denisgav/solderless_breadboard_psu/Doc/usbuart-schematic-2.png

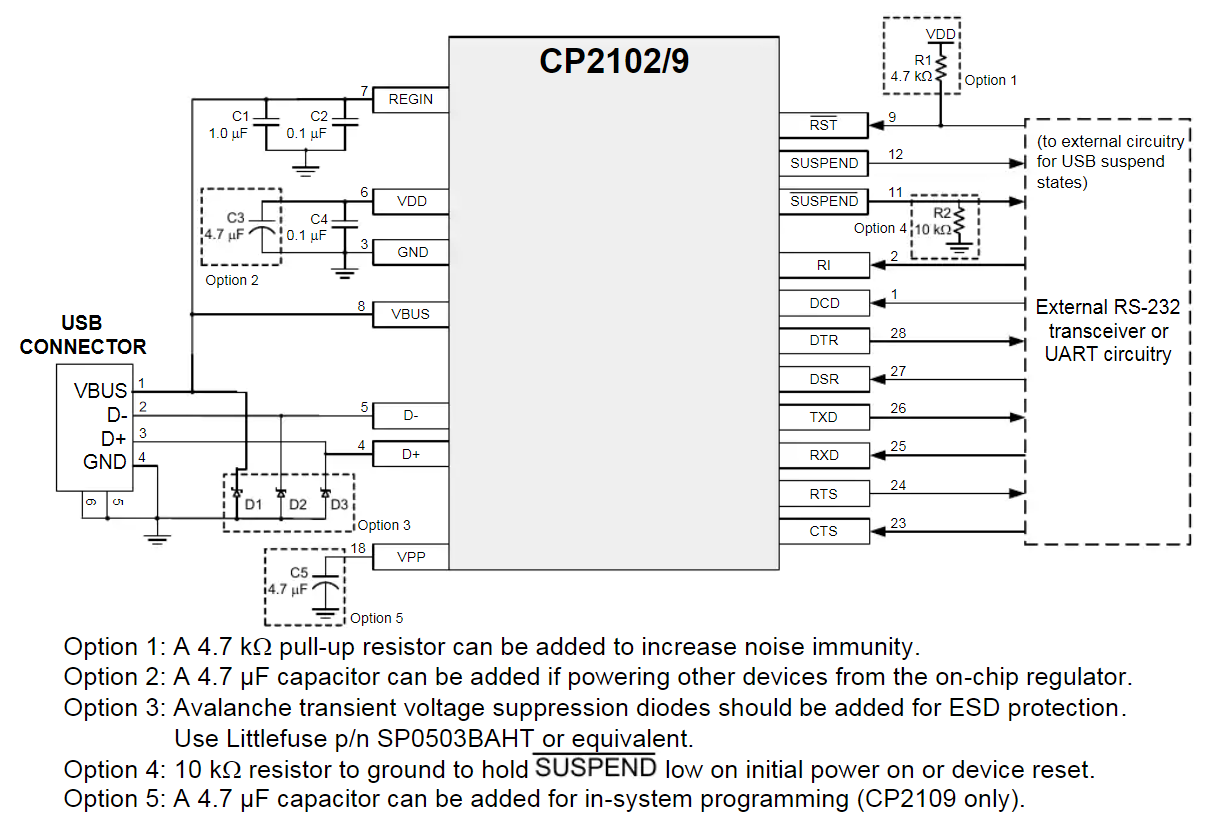
Doc/usbuart-schematic-2.png
