denisgav/solderless_breadboard_psu/Doc/usbuart-schematic.png

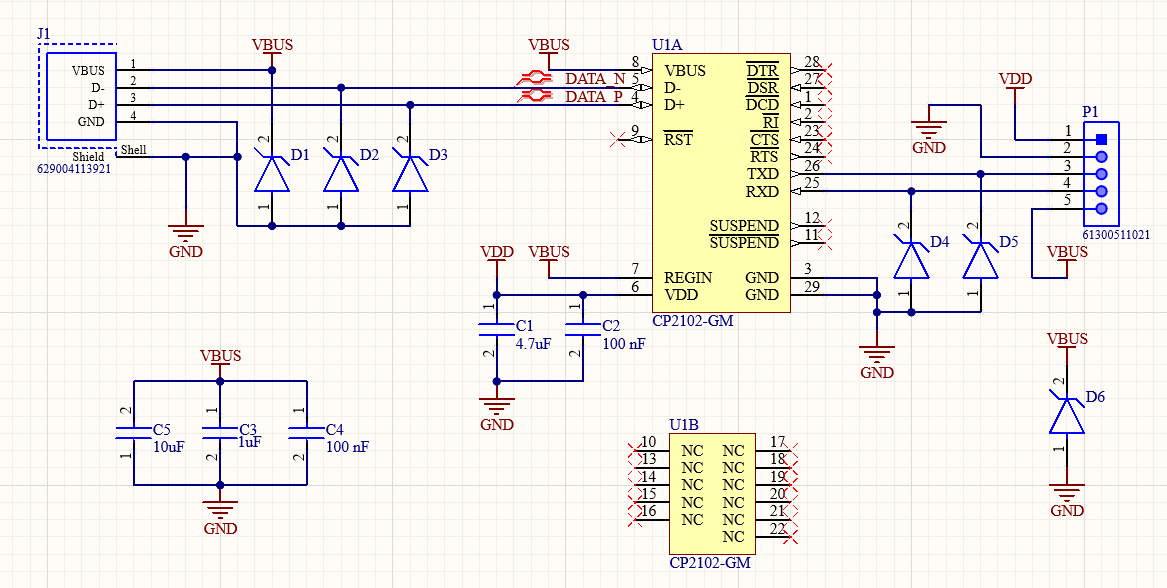
Doc/usbuart-schematic.png
