denisgav/solderless_breadboard_psu/not_ordered.ods

Reference | Qty | Value | DNP | Exclude from BOM | Exclude from Board | Footprint | Datasheet | Manufacturer | Manufacturer Part Number
D401 | 1 | SS14 |  |  |  | Diode_SMD:D_0603_1608Metric | https://www.vishay.com/docs/88746/ss12.pdf | Schottky Diode | SD0603S040S0R2
L401 | 1 | 10uH |  |  |  | Inductor_SMD:L_Changjiang_FXL0630 | ~ | cjiang (Changjiang Microelectronics Tech) | FXL0630-100-M
L402 | 1 | 15uH |  |  |  | Inductor_SMD:L_Changjiang_FXL0630 | ~ | cjiang (Changjiang Microelectronics Tech) | FXL0630-150-M
R301,R401 | 2 | 100kR |  |  |  | Resistor_SMD:R_0402_1005Metric | ~ | UNI-ROYAL(Uniroyal Elec) | 0402WGF1003TCE
R302,R405,R406,R503,R504,R601,R602,R603,R604,R605,R606 | 11 | 510R |  |  |  | Resistor_SMD:R_0402_1005Metric | ~ | UNI-ROYAL(Uniroyal Elec) | 0402WGF5100TCE
R303,R501,R502 | 3 | 5k1R |  |  |  | Resistor_SMD:R_0402_1005Metric | ~ | UNI-ROYAL(Uniroyal Elec) | 0402WGF5101TCE
R304 | 1 | 330R |  |  |  | Resistor_SMD:R_0402_1005Metric | ~ | UNI-ROYAL(Uniroyal Elec) | 0402WGF3300TCE
R305 | 1 | 2k2R |  |  |  | Resistor_SMD:R_0402_1005Metric | ~ | UNI-ROYAL(Uniroyal Elec) | 0402WGF2201TCE
R402,R505 | 2 | 1MR |  |  |  | Resistor_SMD:R_0402_1005Metric | ~ | UNI-ROYAL(Uniroyal Elec) | 0402WGF1004TCE
R403 | 1 | 22kR |  |  |  | Resistor_SMD:R_0402_1005Metric | ~ | UNI-ROYAL(Uniroyal Elec) | 0402WGF2202TCE
R404 | 1 | 330kR |  |  |  | Resistor_SMD:R_0402_1005Metric | ~ | UNI-ROYAL(Uniroyal Elec) | 0402WGF3303TCE
U501 | 1 | USBLC6-2SC6 |  |  |  | Package_TO_SOT_SMD:SOT-23-6 | https://www.st.com/resource/en/datasheet/usblc6-2.pdf | STMicroelectronics | USBLC6-2SC6
