denisgav/solderless_breadboard_psu/KiCad/v2/components/CP2102N-A02-GQFN20R/CP2102N-A02-GQFN20R.stp

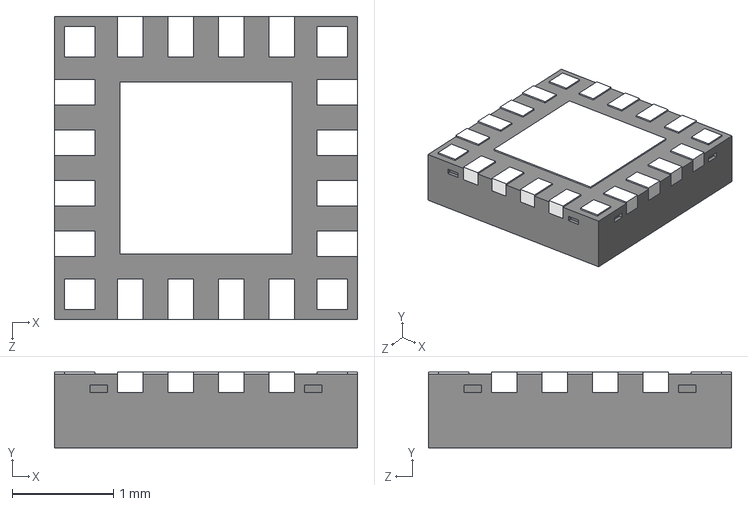
[picture p3: CAD file, 2026-05-03]
KiCad/v2/components/CP2102N-A02-GQFN20R/CP2102N-A02-GQFN20R.stp
3.00 x 0.75 x 3.00 mm
