denisgav/solderless_breadboard_psu/KiCad/v2/components/CP2102N-A02-GQFN24R/CP2102N-A02-GQFN24R.stp

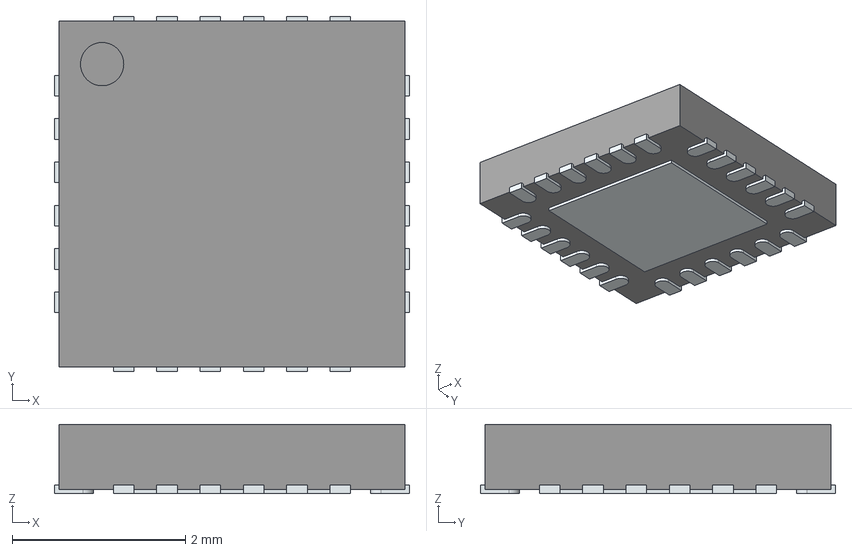
[picture p4: CAD file, 2026-05-03]
KiCad/v2/components/CP2102N-A02-GQFN24R/CP2102N-A02-GQFN24R.stp
4.10 x 4.10 x 0.8 mm
ThermalPin
PinsArrayLR
PinsArrayTB
