denisgav/solderless_breadboard_psu/KiCad/v2/components/HRO  TYPE-C-31-M-12.step

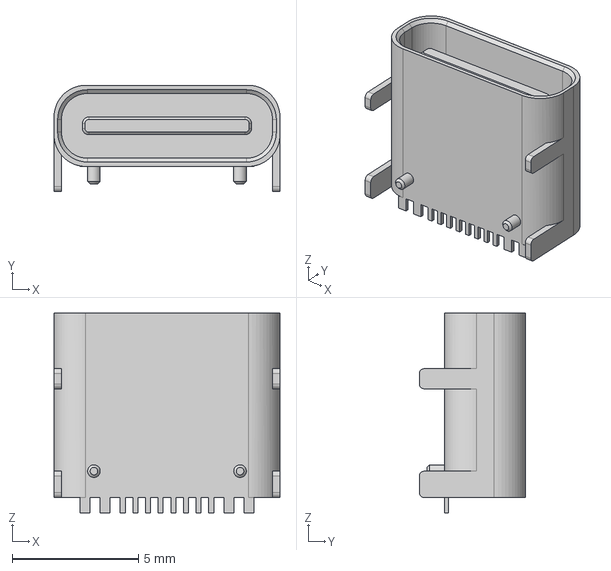
[picture p5: CAD file, 2026-01-18]
KiCad/v2/components/HRO TYPE-C-31-M-12.step
8.94 x 4.21 x 7.90 mm
