denisgav/solderless_breadboard_psu/KiCad/v2/components/SW_PUSH_6mm_H5mm/SW_PUSH_6mm_H5mm.step

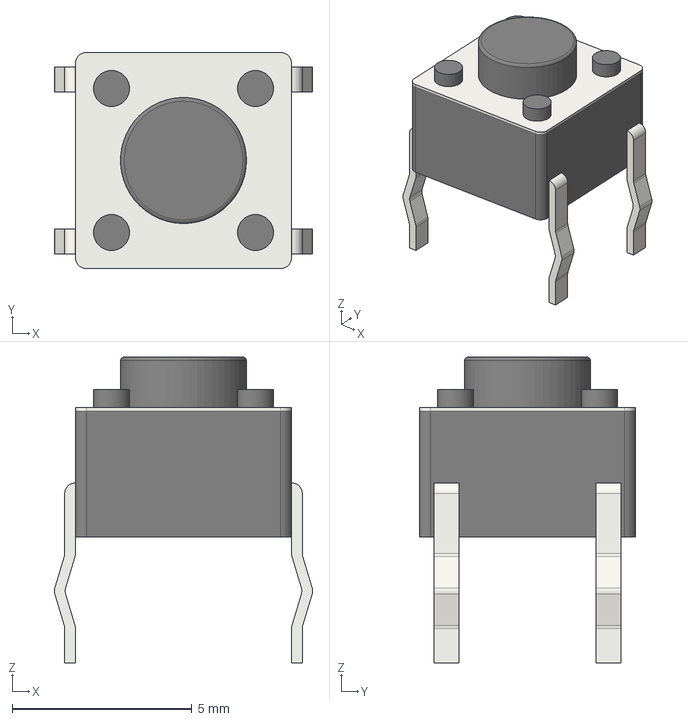
[picture p6: CAD file, 2026-05-06]
KiCad/v2/components/SW_PUSH_6mm_H5mm/SW_PUSH_6mm_H5mm.step
7.17 x 6.00 x 8.50 mm
