denisgav/solderless_breadboard_psu/KiCad/v2/components/TPS63000DRCR/TPS63000DRCR.stp

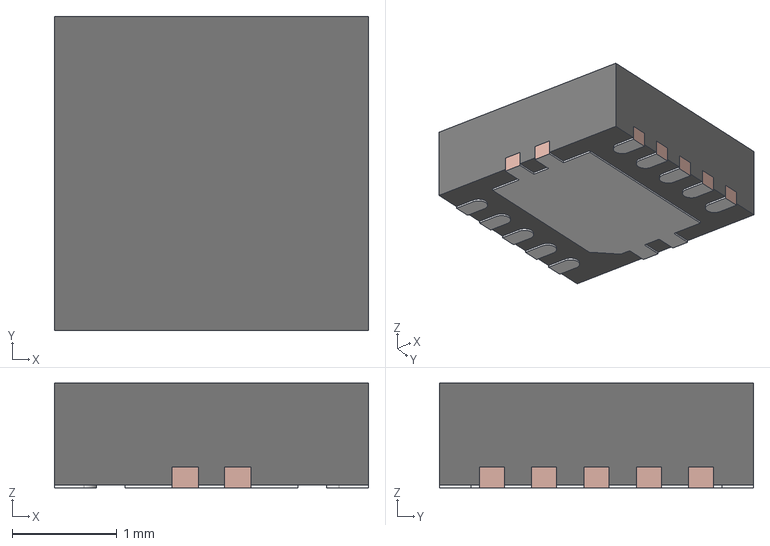
[picture p7: CAD file, 2026-05-03]
KiCad/v2/components/TPS63000DRCR/TPS63000DRCR.stp
3.00 x 3.00 x 1.00 mm
BODY-SON
FRAME-DRC0010J
