denisgav/solderless_breadboard_psu/KiCad/v1/components/BM02B-GHS-TBT_LF__SN__N_/BM02B-GHS-TBT_LF__SN__N_.stp

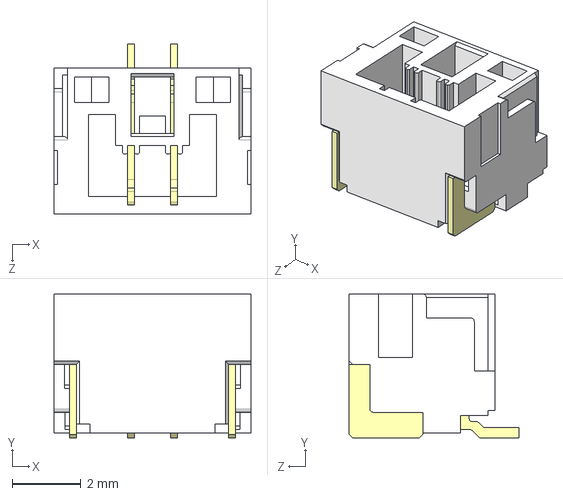
[picture p8: CAD file, 2026-01-10, an earlier design]
KiCad/v1/components/BM02B-GHS-TBT_LF__SN__N_/BM02B-GHS-TBT_LF__SN__N_.stp
5.75 x 4.20 x 4.95 mm
