denisgav/solderless_breadboard_psu/KiCad/v1/components/FT232RL-REEL/FT232RL-REEL.stp

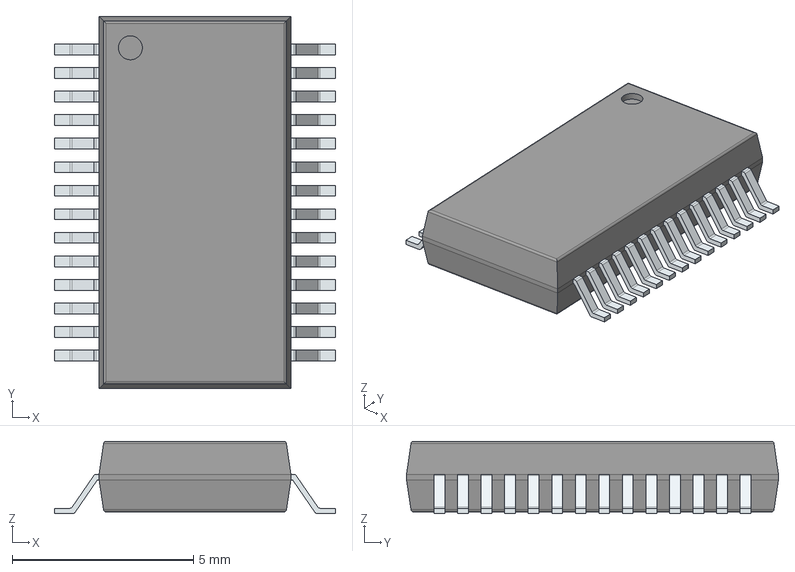
[picture p9: CAD file, 2026-01-10, an earlier design]
KiCad/v1/components/FT232RL-REEL/FT232RL-REEL.stp
7.78 x 10.3 x 2.00 mm
PinsArrayLR
