denisgav/solderless_breadboard_psu/KiCad/v1/components/XKB5858-Z/XKB5858-Z.stp

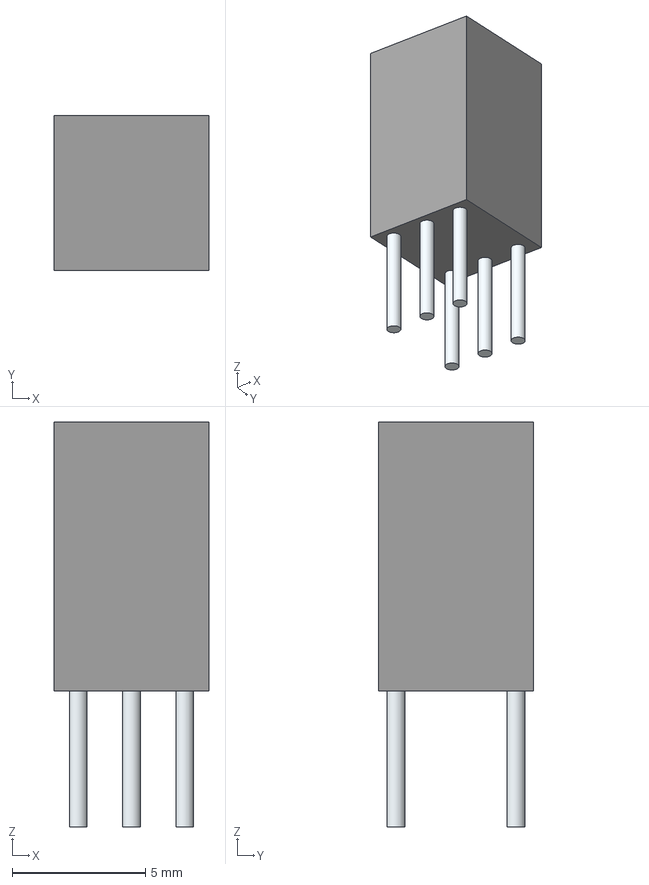
[picture p10: CAD file, 2026-01-10, an earlier design]
KiCad/v1/components/XKB5858-Z/XKB5858-Z.stp
5.80 x 5.80 x 15.2 mm
Leads
