denisgav/solderless_breadboard_psu/KiCad/v1/components/XKB5858-Z/SW_Btn_XLX.step

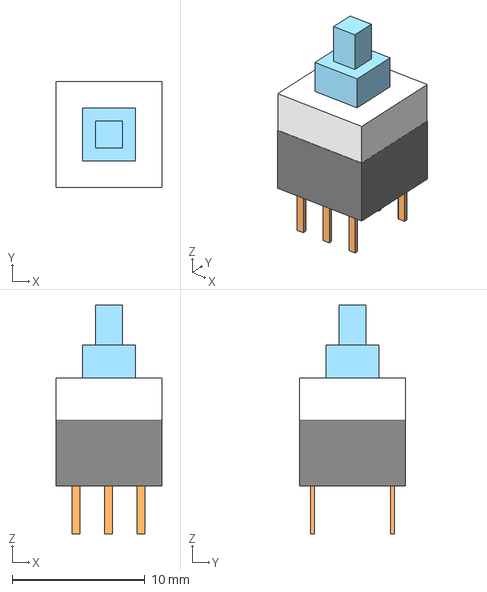
[picture p11: CAD file, 2026-01-10, an earlier design]
KiCad/v1/components/XKB5858-Z/SW_Btn_XLX.step
8.00 x 8.00 x 17.2 mm
