denisgav/solderless_breadboard_psu/KiCad/v1/components/BQ29737DSER/BQ29737DSER.stp

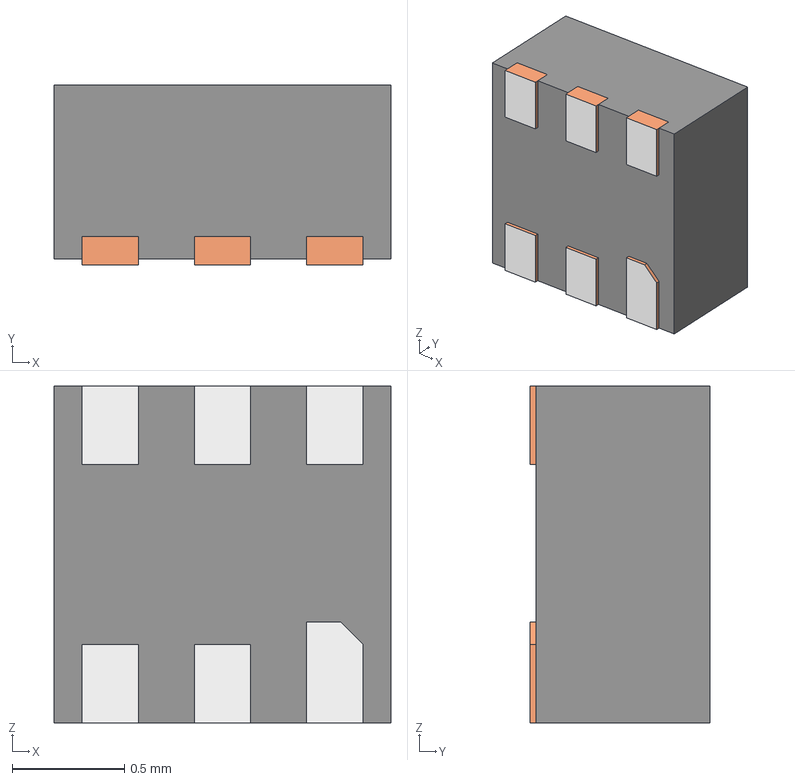
[picture p12: CAD file, 2026-01-10, an earlier design]
KiCad/v1/components/BQ29737DSER/BQ29737DSER.stp
1.50 x 0.8 x 1.50 mm
BODY-SON
FRAME-DSE0006A
