denisgav/solderless_breadboard_psu/KiCad/v1/components/MCP73831T-2ACI_OT/MCP73831T-2ACI_OT.stp

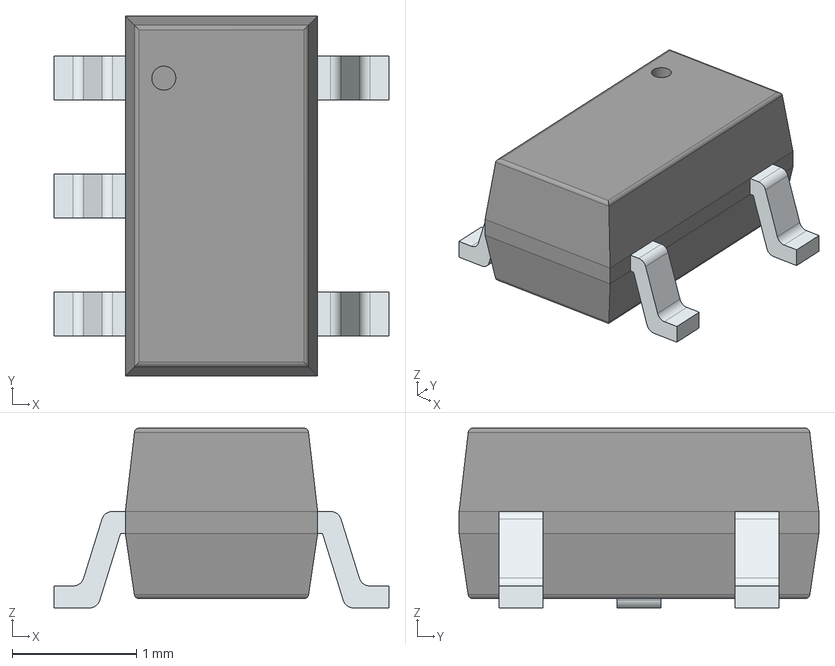
[picture p13: CAD file, 2026-01-10, an earlier design]
KiCad/v1/components/MCP73831T-2ACI_OT/MCP73831T-2ACI_OT.stp
2.70 x 2.90 x 1.45 mm
PinsArrayL
PinsArrayR
