denisgav/solderless_breadboard_psu/KiCad/v1/components/TLV62569DBVR/TLV62569DBVR.stp

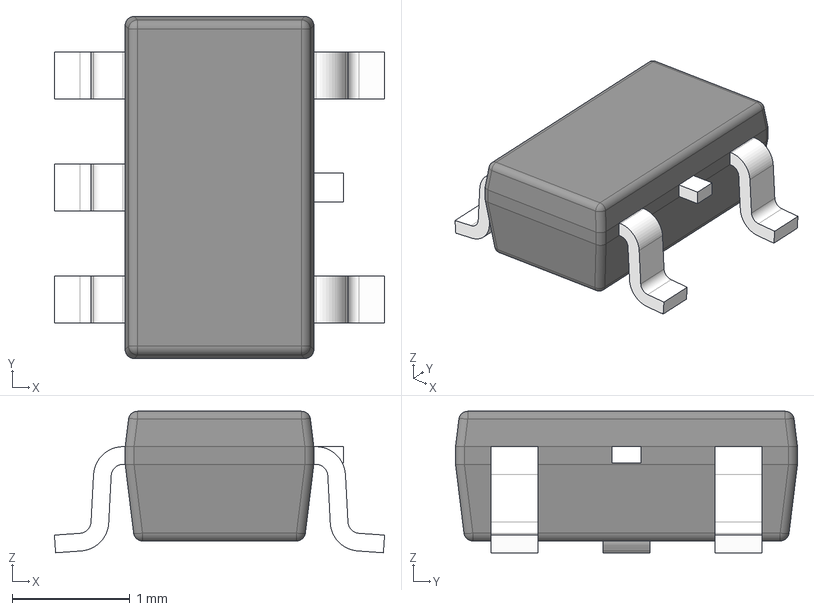
[picture p14: CAD file, 2026-01-10, an earlier design]
KiCad/v1/components/TLV62569DBVR/TLV62569DBVR.stp
2.80 x 2.90 x 1.20 mm
BODY-SOT
LEAD-SOT x 5
LEAD-DUMMY
