denisgav/solderless_breadboard_psu/KiCad/v1/components/TPS61040DBVR/TPS61040DBVR.step

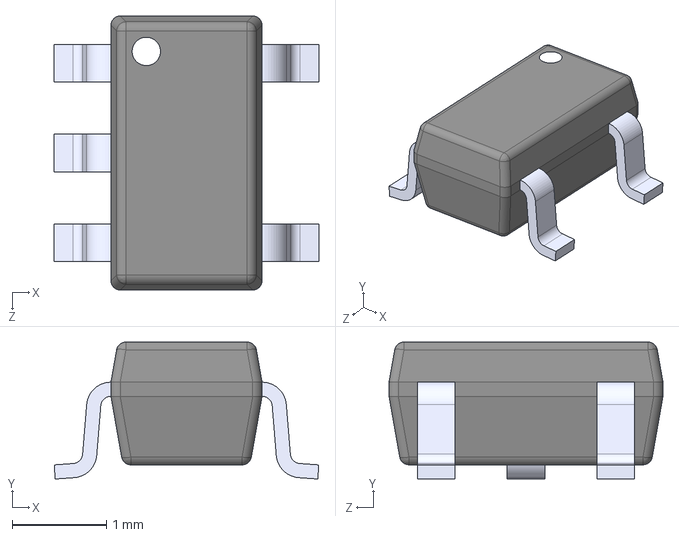
[picture p15: CAD file, 2026-01-10, an earlier design]
KiCad/v1/components/TPS61040DBVR/TPS61040DBVR.step
2.80 x 1.45 x 2.90 mm
