denisgav/solderless_breadboard_psu/KiCad/v2/solderless_breadboard_psu.kicad_pcb

## KiCad design KiCad/v2/solderless_breadboard_psu.kicad_pcb (2026-07-12)

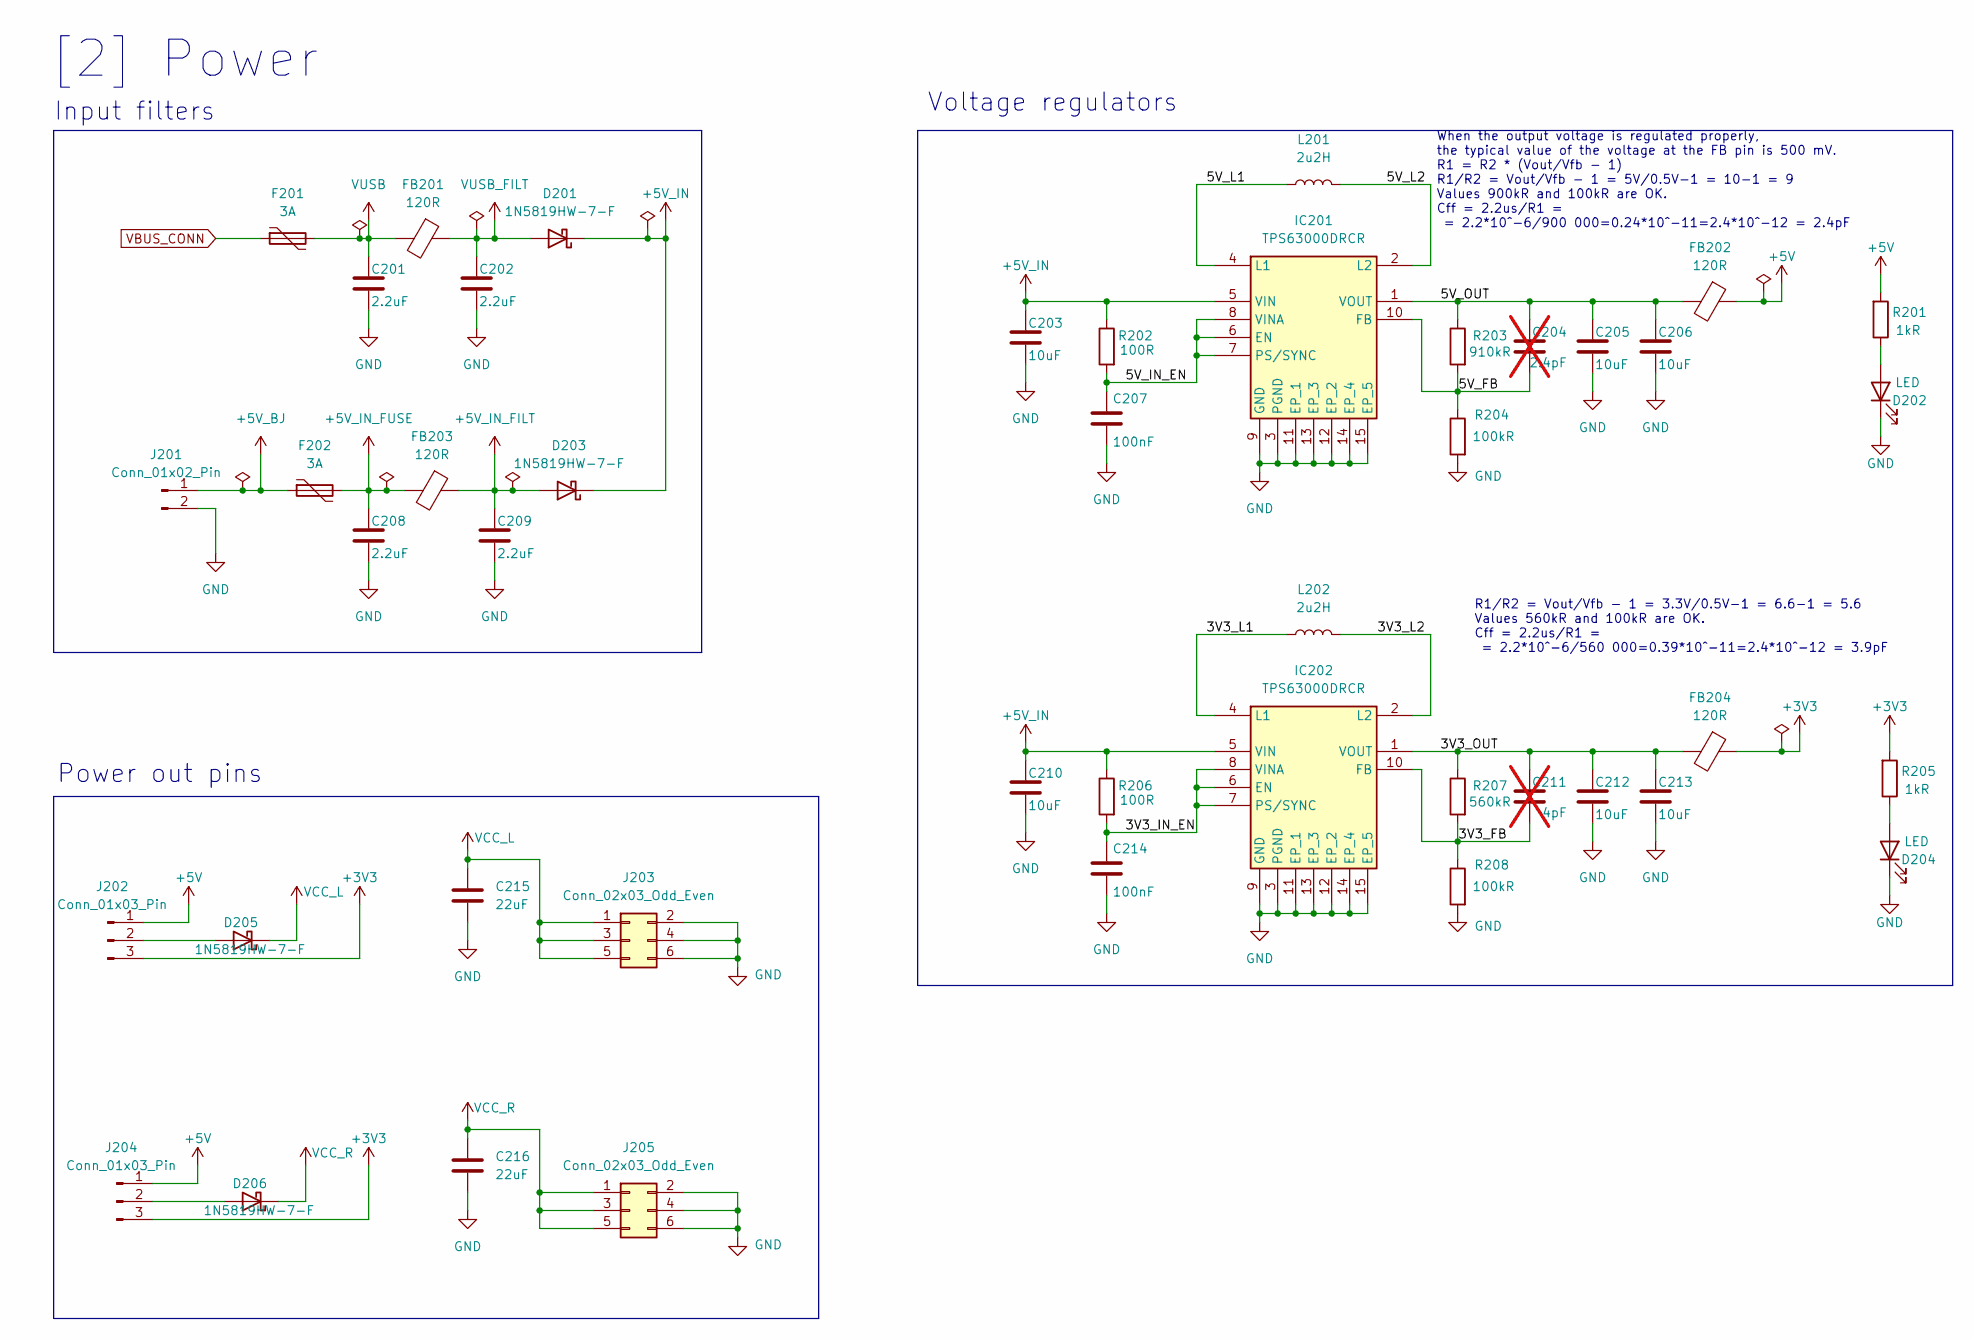
[picture p16: schematic 02_power.kicad_sch]

Parts:
C201, C202, C208, C209: 2.2uF; C_0603_1608Metric; Manufacturer Part Number CL10A225KO8NNNC; LCSC Part Number C23630
C203, C205, C206, C210, C212, C213: 10uF; C_0603_1608Metric; Manufacturer Part Number GRM188R61E106MA73D; LCSC Part Number C91606
C204: 2.4pF; C_0603_1608Metric; Manufacturer Part Number CC0603BRNPO9BN2R4; LCSC Part Number C519102; not fitted
C207, C214: 100nF; C_0402_1005Metric; Manufacturer Part Number GCM155R71H104KE02D; LCSC Part Number C85858
C211: 4pF; C_0603_1608Metric; not fitted
C215, C216: 22uF; C_0603_1608Metric; Manufacturer Part Number CL10A226MP8NUNE; DigiKey Part Number 1276-6687-6-ND
D201, D203, D205, D206: 1N5819HW-7-F; D_SOD-123; Manufacturer Part Number 1N5819HW-7-F; LCSC Part Number C82544
D202, D204: LED; LED_0603_1608Metric; Manufacturer Part Number XL-1608SURC-06; LCSC Part Number C965799
F201, F202: 3A; Fuse_0805_2012Metric; Manufacturer Part Number BSMD0805-100-6V; LCSC Part Number C883112
FB201, FB202, FB203, FB204: 120R; Fuse_0603_1608Metric; Manufacturer Part Number BLM18PG121SN1D; LCSC Part Number C14709
IC201, IC202: TPS63000DRCR; TPS63002DRCR; Manufacturer_Part_Number TPS63000DRCR; Mouser Part Number 595-TPS63000DRCR
J201: Conn_01x02_Pin; PinHeader_1x02_P2.54mm_Vertical
J202, J204: Conn_01x03_Pin; PinHeader_1x03_P2.54mm_Vertical
J203, J205: Conn_02x03_Odd_Even; PinHeader_2x03_P2.54mm_Vertical
L201, L202: 2u2H; L_Changjiang_FXL0630; Manufacturer Part Number FXL0630-2R2-M; LCSC Part Number C167218
R201, R205: 1kR; R_0402_1005Metric; Manufacturer Part Number RC0402FR-071KL; LCSC Part Number C106235
R202, R206: 100R; R_0402_1005Metric; Manufacturer Part Number RT0402BRD07100RL; LCSC Part Number C705627
R203: 910kR; R_0402_1005Metric; Manufacturer Part Number FRC0402F9103TS; LCSC Part Number C2909391
R204, R208: 100kR; R_0402_1005Metric; Manufacturer Part Number RT0402BRD07100KL; LCSC Part Number C852472
R207: 560kR; R_0402_1005Metric; Manufacturer Part Number 0402WGF5603TCE; LCSC Part Number C132339

Connections:
+3V3: FB204.1, J202.3, J204.3, R205.2
+5V: FB202.1, J202.1, J204.1, R201.2
+5V_BJ: F202.1, J201.1
+5V_IN: C203.1, C210.1, D201.1 (K), D203.1 (K), IC201.5 (VIN), IC202.5 (VIN), R202.1, R206.1
+5V_IN_FILT: C209.1, D203.2 (A), FB203.1
+5V_IN_FUSE: C208.1, F202.2, FB203.2
/[2] Power/3V3_FB: C211.2, IC202.10 (FB), R207.2, R208.1
/[2] Power/3V3_IN_EN: C214.1, IC202.6 (EN), IC202.7 (PS/SYNC), IC202.8 (VINA), R206.2
/[2] Power/3V3_L1: IC202.4 (L1), L202.1
/[2] Power/3V3_L2: IC202.2 (L2), L202.2
/[2] Power/3V3_OUT: C211.1, C212.1, C213.1, FB204.2, IC202.1 (VOUT), R207.1
/[2] Power/5V_FB: C204.2, IC201.10 (FB), R203.2, R204.1
/[2] Power/5V_IN_EN: C207.1, IC201.6 (EN), IC201.7 (PS/SYNC), IC201.8 (VINA), R202.2
/[2] Power/5V_L1: IC201.4 (L1), L201.1
/[2] Power/5V_L2: IC201.2 (L2), L201.2
/[2] Power/5V_OUT: C204.1, C205.1, C206.1, FB202.2, IC201.1 (VOUT), R203.1
GND: C201.2, C202.2, C203.2, C205.2, C206.2, C207.2, C208.2, C209.2, C210.2, C212.2, C213.2, C214.2, C215.2, C216.2, D202.1 (K), D204.1 (K), IC201.3 (PGND), IC201.9 (GND), IC201.11 (EP_1), IC201.12 (EP_2), IC201.13 (EP_3), IC201.14 (EP_4), IC201.15 (EP_5), IC202.3 (PGND), IC202.9 (GND), IC202.11 (EP_1), IC202.12 (EP_2), IC202.13 (EP_3), IC202.14 (EP_4), IC202.15 (EP_5), J201.2, J203.2, J203.4, J203.6, J205.2, J205.4, J205.6, R204.2, R208.2; also elsewhere on the board
unnamed: D202.2 (A), R201.1
unnamed: D204.2 (A), R205.1
unnamed: D205.2 (A), J202.2
unnamed: D206.2 (A), J204.2
VBUS_CONN: F201.1; also elsewhere on the board
VCC_L: C215.1, D205.1 (K), J203.1, J203.3, J203.5
VCC_R: C216.1, D206.1 (K), J205.1, J205.3, J205.5
VUSB: C201.1, F201.2, FB201.2; also elsewhere on the board
VUSB_FILT: C202.1, D201.2 (A), FB201.1; also elsewhere on the board

Notes on the sheet:
Input filters
Voltage regulators
When the output voltage is regulated properly, the typical value of the voltage at the FB pin is 500 mV. R1 = R2 * (Vout/Vfb - 1) R1/R2 = Vout/Vfb - 1 = 5V/0.5V-1 = 10-1 = 9 Values 900kR and 100kR are OK. Cff = 2.2us/R1 = = 2.2*10^-6/900 000=0.24*10^-11=2.4*10^-12 = 2.4pF
[2] Power
Power out pins
R1/R2 = Vout/Vfb - 1 = 3.3V/0.5V-1 = 6.6-1 = 5.6 Values 560kR and 100kR are OK. Cff = 2.2us/R1 = = 2.2*10^-6/560 000=0.39*10^-11=2.4*10^-12 = 3.9pF

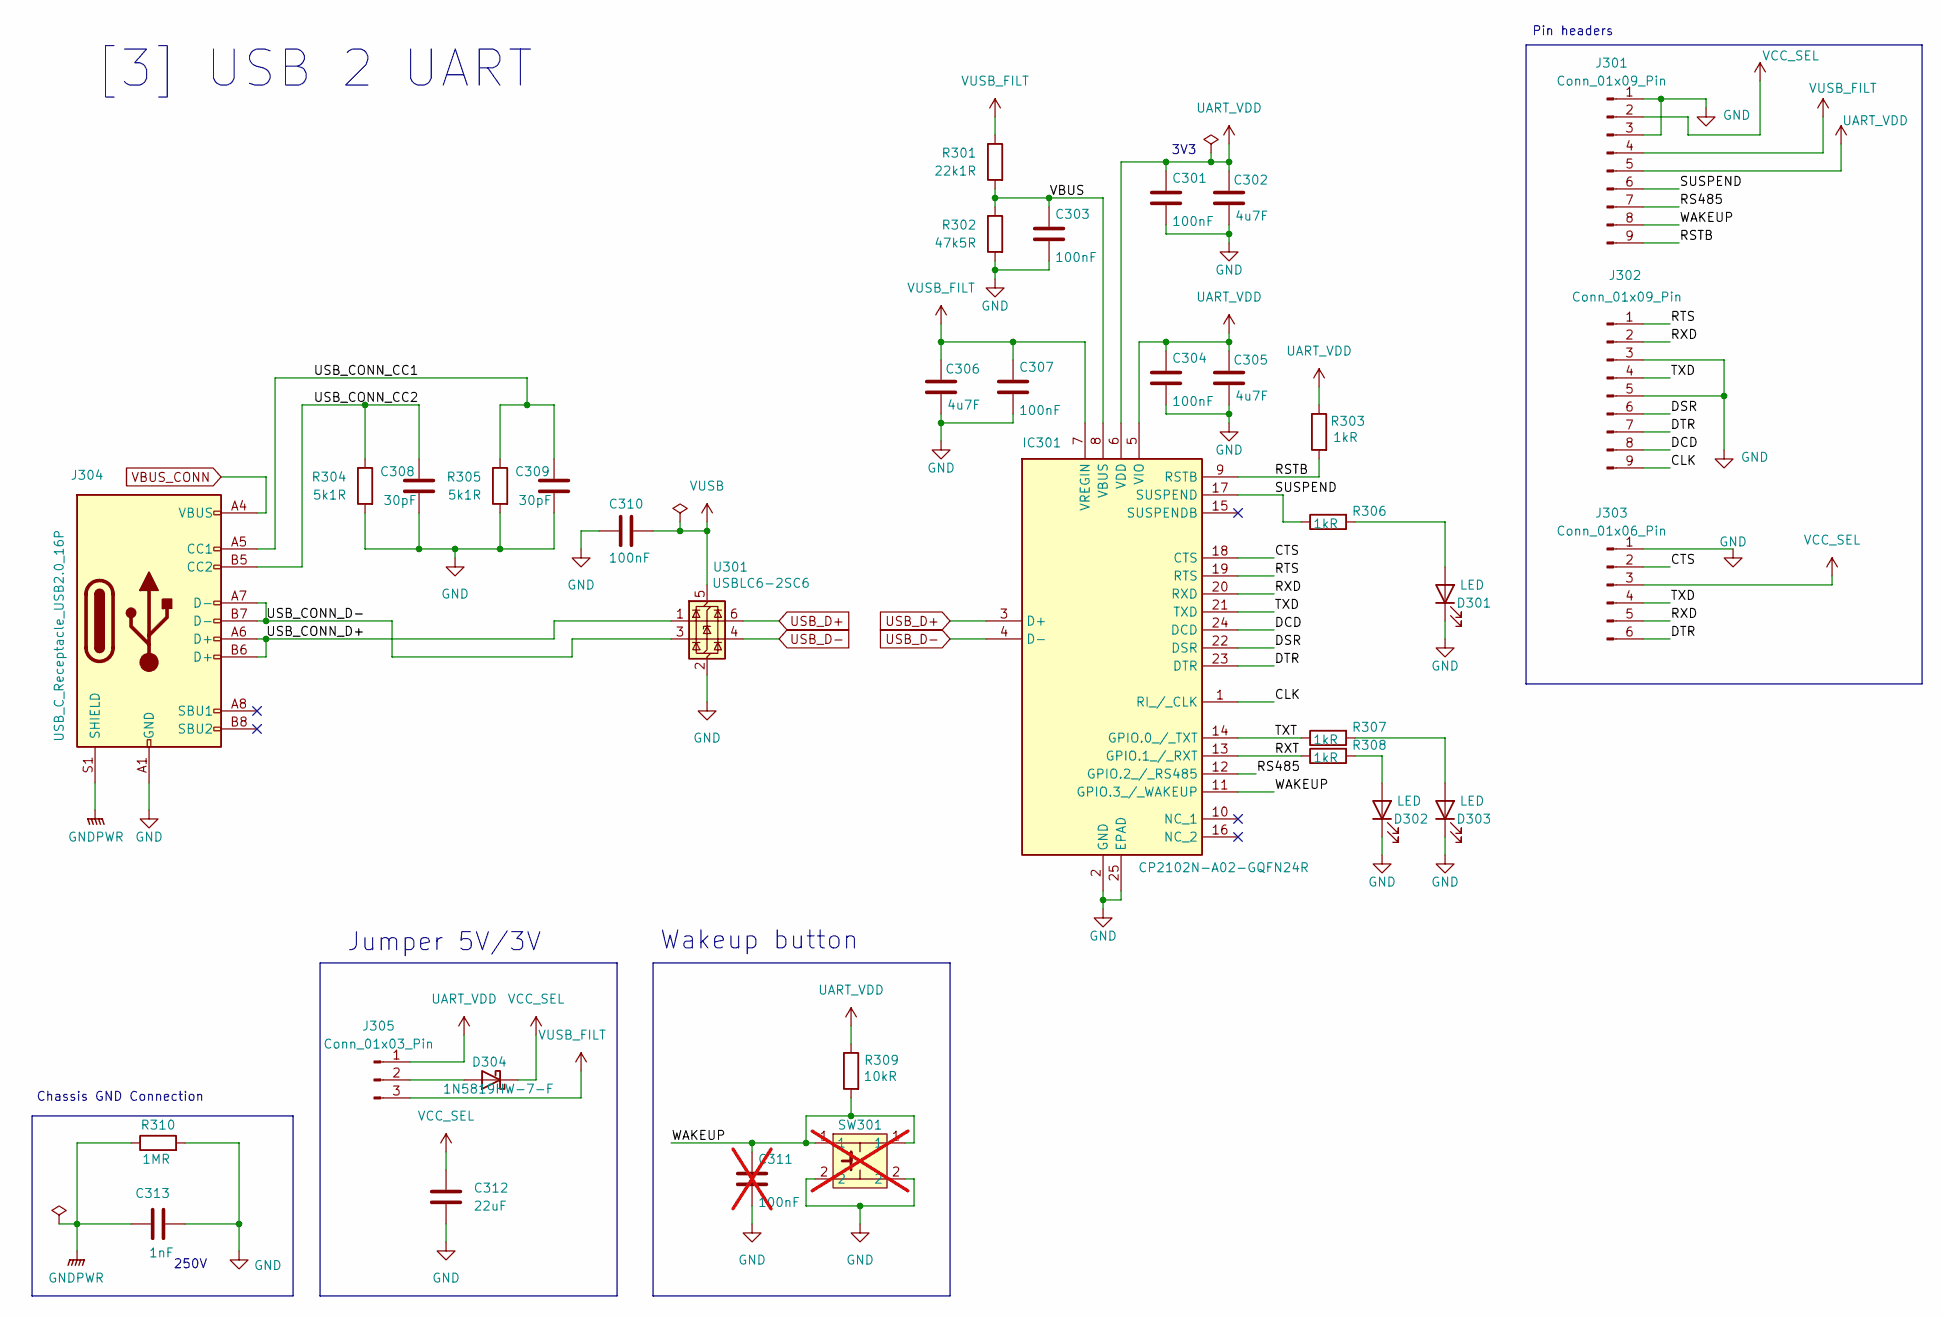
[picture p17: schematic 03_usb2uart.kicad_sch]

Parts:
C301, C303, C304, C307, C310: 100nF; C_0402_1005Metric; Manufacturer Part Number GCM155R71H104KE02D; LCSC Part Number C85858
C302, C305, C306: 4u7F; C_0603_1608Metric; Manufacturer Part Number CL10A475KP8NNNC; LCSC Part Number C1705
C308, C309: 30pF; C_0603_1608Metric; Manufacturer Part Number CC0603JRNPO9BN300; LCSC Part Number C113797
C311: 100nF; C_0402_1005Metric; Manufacturer Part Number GCM155R71H104KE02D; LCSC Part Number C85858; not fitted
C312: 22uF; C_0603_1608Metric; Manufacturer Part Number CL10A226MP8NUNE; DigiKey Part Number 1276-6687-6-ND
C313: 1nF; C_0603_1608Metric; Manufacturer Part Number CC0603KRX7R9BB102; LCSC Part Number C100040
D301, D302, D303: LED; LED_0603_1608Metric; Manufacturer Part Number XL-1608SURC-06; LCSC Part Number C965799
D304: 1N5819HW-7-F; D_SOD-123; Manufacturer Part Number 1N5819HW-7-F; LCSC Part Number C82544
IC301: CP2102N-A02-GQFN24R; QFN50P400X400X80-25N-D; Manufacturer_Part_Number CP2102N-A02-GQFN24R; Mouser Part Number 634-CP2102NA02QFN24R
J301, J302: Conn_01x09_Pin; PinHeader_1x09_P2.54mm_Vertical
J303: Conn_01x06_Pin; PinHeader_1x06_P2.54mm_Vertical
J304: USB_C_Receptacle_USB2.0_16P; USB_C_Receptacle_HCTL_HC-TYPE-C-16P-01A; Manufacturer Part Number TYPE-C-31-M-12; LCSC Part Number C165948
J305: Conn_01x03_Pin; PinHeader_1x03_P2.54mm_Vertical
R301: 22k1R; R_0402_1005Metric; Manufacturer Part Number CRCW040222K1FKED; LCSC Part Number C844504
R302: 47k5R; R_0402_1005Metric; Manufacturer Part Number RT0402DRE0747K5L; LCSC Part Number C853963
R303, R306, R307, R308: 1kR; R_0402_1005Metric; Manufacturer Part Number RC0402FR-071KL; LCSC Part Number C106235
R304, R305: 5k1R; R_0402_1005Metric; Manufacturer Part Number RT0402BRD075K1L; LCSC Part Number C852856
R309: 10kR; R_0402_1005Metric; Manufacturer Part Number CQ02WGF1002TCE; LCSC Part Number C2765610
R310: 1MR; R_0402_1005Metric; Manufacturer Part Number RE0402BRE071ML; LCSC Part Number C1883577
SW301: SW_PUSH_6mm_H5mm; Manufacturer Part Number SMG-01-H080A1; LCSC Part Number C29781314; not fitted
U301: USBLC6-2SC6; SOT-23-6; Manufacturer Part Number USBLC6-2SC6; LCSC Part Number C7519

Connections:
/[3] USB 2 UART/CLK: IC301.1 (RI_/_CLK), J302.9
/[3] USB 2 UART/CTS: IC301.18 (CTS), J303.2
/[3] USB 2 UART/DCD: IC301.24 (DCD), J302.8
/[3] USB 2 UART/DSR: IC301.22 (DSR), J302.6
/[3] USB 2 UART/DTR: IC301.23 (DTR), J302.7, J303.6
/[3] USB 2 UART/RS485: IC301.12 (GPIO.2_/_RS485), J301.7
/[3] USB 2 UART/RSTB: IC301.9 (RSTB), J301.9, R303.2
/[3] USB 2 UART/RTS: IC301.19 (RTS), J302.1
/[3] USB 2 UART/RXD: IC301.20 (RXD), J302.2, J303.5
/[3] USB 2 UART/RXT: IC301.13 (GPIO.1_/_RXT), R308.1
/[3] USB 2 UART/SUSPEND: IC301.17 (SUSPEND), J301.6, R306.1
/[3] USB 2 UART/TXD: IC301.21 (TXD), J302.4, J303.4
/[3] USB 2 UART/TXT: IC301.14 (GPIO.0_/_TXT), R307.1
/[3] USB 2 UART/USB_CONN_CC1: C309.1, J304.A5 (CC1), R305.1
/[3] USB 2 UART/USB_CONN_CC2: C308.1, J304.B5 (CC2), R304.1
/[3] USB 2 UART/USB_CONN_D+: J304.A6 (D+), J304.B6 (D+), U301.1 (I/O1)
/[3] USB 2 UART/USB_CONN_D-: J304.A7 (D-), J304.B7 (D-), U301.3 (I/O2)
/[3] USB 2 UART/VBUS: C303.1, IC301.8 (VBUS), R301.2, R302.1
/[3] USB 2 UART/WAKEUP: C311.1, IC301.11 (GPIO.3_/_WAKEUP), J301.8, R309.2, SW301.1
GND: C301.2, C302.2, C303.2, C304.2, C305.2, C306.2, C307.2, C308.2, C309.2, C310.2, C311.2, C312.2, C313.2, D301.1 (K), D302.1 (K), D303.1 (K), IC301.2 (GND), IC301.25 (EPAD), J301.1, J301.3, J302.3, J302.5, J303.1, J304.A1 (GND), J304.A12 (GND), J304.B1 (GND), J304.B12 (GND), R302.2, R304.2, R305.2, R310.2, SW301.2, U301.2 (GND); also elsewhere on the board
GNDPWR: C313.1, J304.S1 (SHIELD), R310.1
unnamed: D301.2 (A), R306.2
unnamed: D302.2 (A), R308.2
unnamed: D303.2 (A), R307.2
unnamed: D304.2 (A), J305.2
UART_VDD: C301.1, C302.1, C304.1, C305.1, IC301.5 (VIO), IC301.6 (VDD), J301.5, J305.1, R303.1, R309.1
USB_D+: IC301.3 (D+), U301.6 (I/O1)
USB_D-: IC301.4 (D-), U301.4 (I/O2)
VBUS_CONN: J304.A4 (VBUS), J304.A9 (VBUS), J304.B4 (VBUS), J304.B9 (VBUS); also elsewhere on the board
VCC_SEL: C312.1, D304.1 (K), J301.2, J303.3
VUSB: C310.1, U301.5 (VBUS); also elsewhere on the board
VUSB_FILT: C306.1, C307.1, IC301.7 (VREGIN), J301.4, J305.3, R301.1; also elsewhere on the board

Notes on the sheet:
Jumper 5V/3V
3V3
Pin headers
Wakeup button
Chassis GND Connection
250V
[3] USB 2 UART

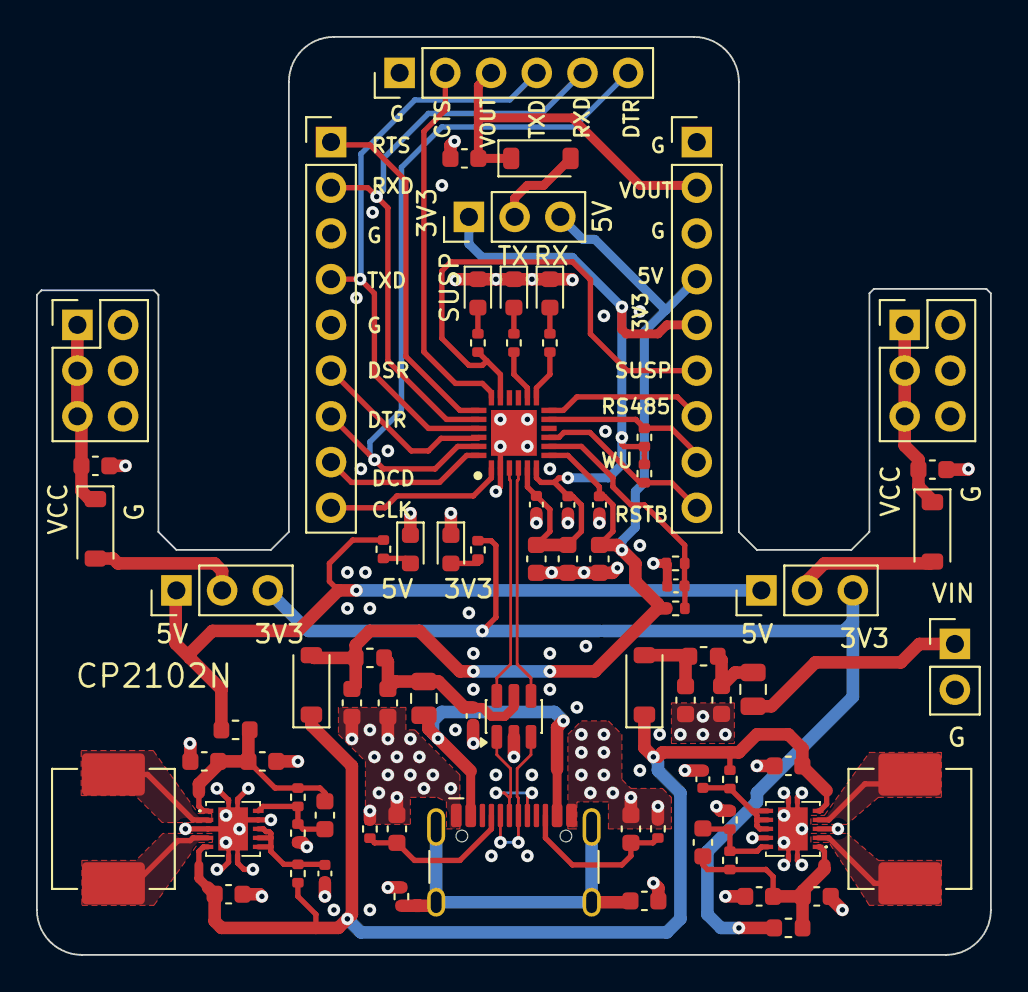
[picture p18: board KiCad/v2/solderless_breadboard_psu.kicad_pcb from above]

Board: 4 copper layers, 53.0 x 51.0 mm, 78 parts (0 on the bottom side), 54 nets.
