denisgav/solderless_breadboard_psu/KiCad/v1/solderless_breadboard_psu.kicad_pcb

## KiCad design KiCad/v1/solderless_breadboard_psu.kicad_pcb (2026-05-03, an earlier design)

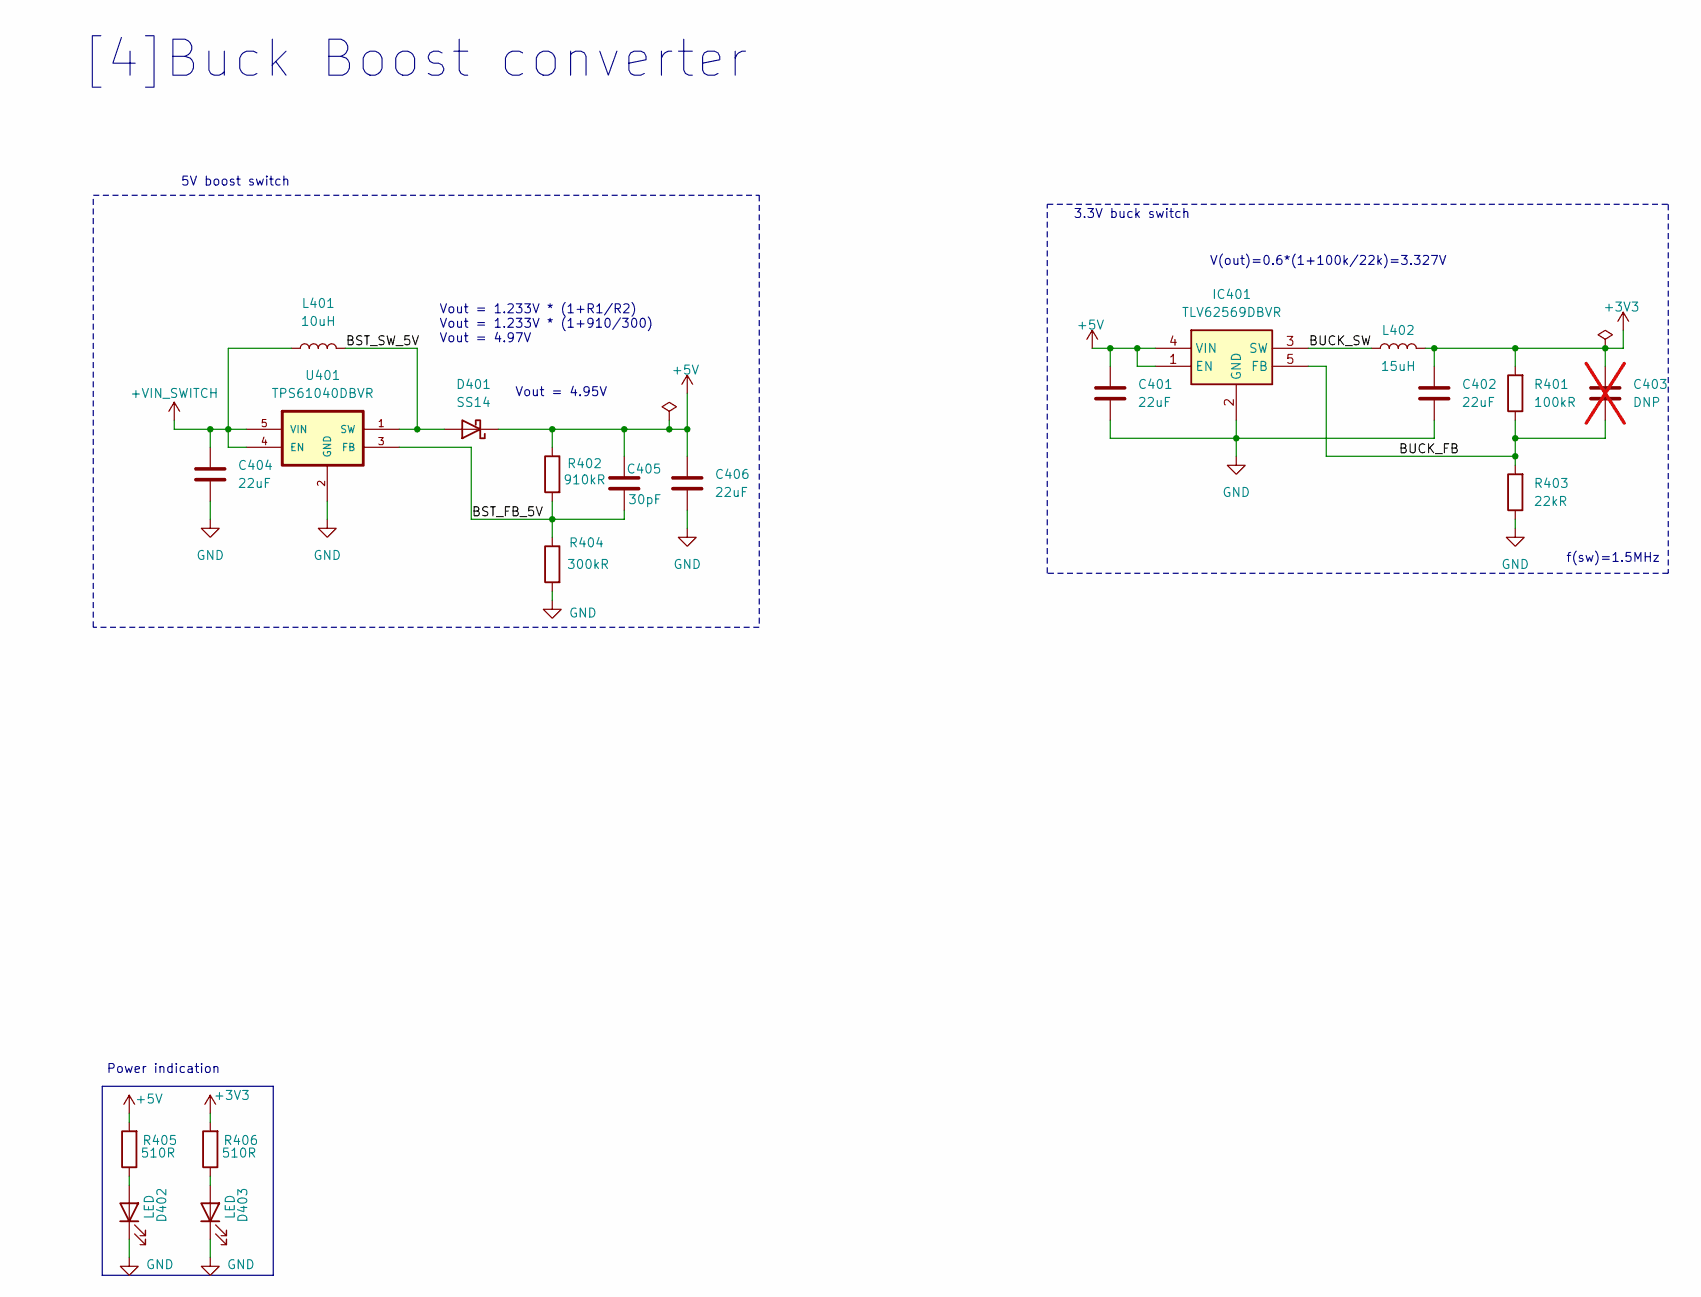
[picture p19: schematic 04_buck_boost.kicad_sch]

Parts:
C401, C402, C404, C406: 22uF; C_0603_1608Metric; Manufacturer Part Number CL10A226MP8NUNE; DigiKey Part Number 1276-6687-6-ND
C403: DNP; C_0402_1005Metric; not fitted
C405: 30pF; C_0603_1608Metric; Manufacturer Part Number CC0603JRNPO9BN300
D401: SS14; D_0603_1608Metric; Manufacturer Part Number SD0603S040S0R2
D402, D403: LED; LED_0603_1608Metric; Manufacturer Part Number XL-1608SURC-06
IC401: TLV62569DBVR; SOT95P280X145-5N; Manufacturer Part Number TLV62569DBVR
L401: 10uH; L_Changjiang_FXL0630; Manufacturer Part Number FXL0630-100-M
L402: 15uH; L_Changjiang_FXL0630; Manufacturer Part Number FXL0630-150-M; DigiKey Part Number 3442-MWSA0603S-150MTDKR-ND
R401: 100kR; R_0402_1005Metric; Manufacturer Part Number 0402WGF1003TCE; DigiKey Part Number P100KLDKR-ND
R402: 910kR; R_0402_1005Metric; Manufacturer Part Number 0402WGJ0914TCE
R403: 22kR; R_0402_1005Metric; Manufacturer Part Number 0402WGF2202TCE; DigiKey Part Number P22.0KLDKR-ND
R404: 300kR; R_0402_1005Metric; Manufacturer Part Number 0402WGF3003TCE
R405, R406: 510R; R_0402_1005Metric; Manufacturer Part Number 0402WGF5100TCE
U401: TPS61040DBVR; Manufacturer Part Number TPS61040DBVR

Connections:
+3V3: C402.1, C403.1, L402.2, R401.2, R406.2; also elsewhere on the board
+5V: C401.1, C405.1, C406.1, D401.1 (K), IC401.1 (EN), IC401.4 (VIN), R402.1, R405.2; also elsewhere on the board
+VIN_SWITCH: C404.1, L401.1, U401.4 (EN), U401.5 (VIN); also elsewhere on the board
/[4]Buck Boost converter/BST_FB_5V: C405.2, R402.2, R404.1, U401.3 (FB)
/[4]Buck Boost converter/BST_SW_5V: D401.2 (A), L401.2, U401.1 (SW)
/[4]Buck Boost converter/BUCK_FB: C403.2, IC401.5 (FB), R401.1, R403.2
/[4]Buck Boost converter/BUCK_SW: IC401.3 (SW), L402.1
GND: C401.2, C402.2, C404.2, C406.2, D402.1 (K), D403.1 (K), IC401.2 (GND), R403.1, R404.2, U401.2 (GND); also elsewhere on the board
unnamed: D402.2 (A), R405.1
unnamed: D403.2 (A), R406.1

Notes on the sheet:
Vout = 1.233V * (1+R1/R2) Vout = 1.233V * (1+910/300) Vout = 4.97V
[4]Buck Boost converter
Vout = 4.95V
3.3V buck switch
Power indication
V(out)=0.6*(1+100k/22k)=3.327V
f(sw)=1.5MHz
5V boost switch

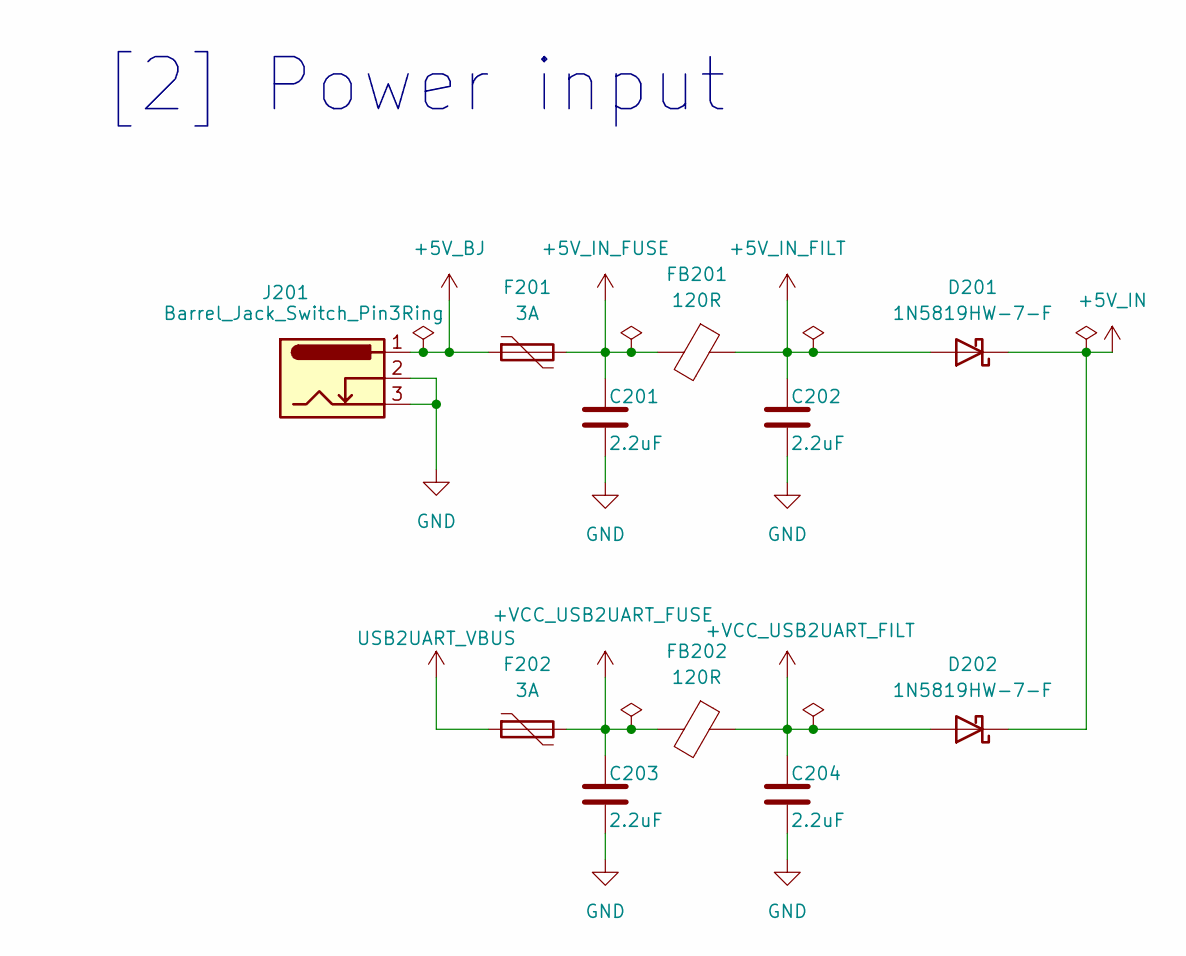
[picture p20: schematic 02_power_input.kicad_sch]

Parts:
C201, C202, C203, C204: 2.2uF; C_0603_1608Metric; Manufacturer Part Number CL10A225KO8NNNC
D201, D202: 1N5819HW-7-F; D_SOD-123; Manufacturer Part Number 1N5819HW-7-F
F201, F202: 3A; Fuse_0805_2012Metric; Manufacturer Part Number BSMD0805-100-6V
FB201, FB202: 120R; Fuse_0603_1608Metric; Manufacturer Part Number BLM18PG121SN1D
J201: Barrel_Jack_Switch_Pin3Ring; BarrelJack_GCT_DCJ200-10-A_Horizontal; Manufacturer Part Number DC005

Connections:
+5V_BJ: F201.1, J201.1
+5V_IN: D201.1 (K), D202.1 (K); also elsewhere on the board
+5V_IN_FILT: C202.1, D201.2 (A), FB201.1
+5V_IN_FUSE: C201.1, F201.2, FB201.2
+VCC_USB2UART_FILT: C204.1, D202.2 (A), FB202.1; also elsewhere on the board
+VCC_USB2UART_FUSE: C203.1, F202.2, FB202.2
GND: C201.2, C202.2, C203.2, C204.2, J201.2, J201.3; also elsewhere on the board
USB2UART_VBUS: F202.1; also elsewhere on the board

Notes on the sheet:
[2] Power input

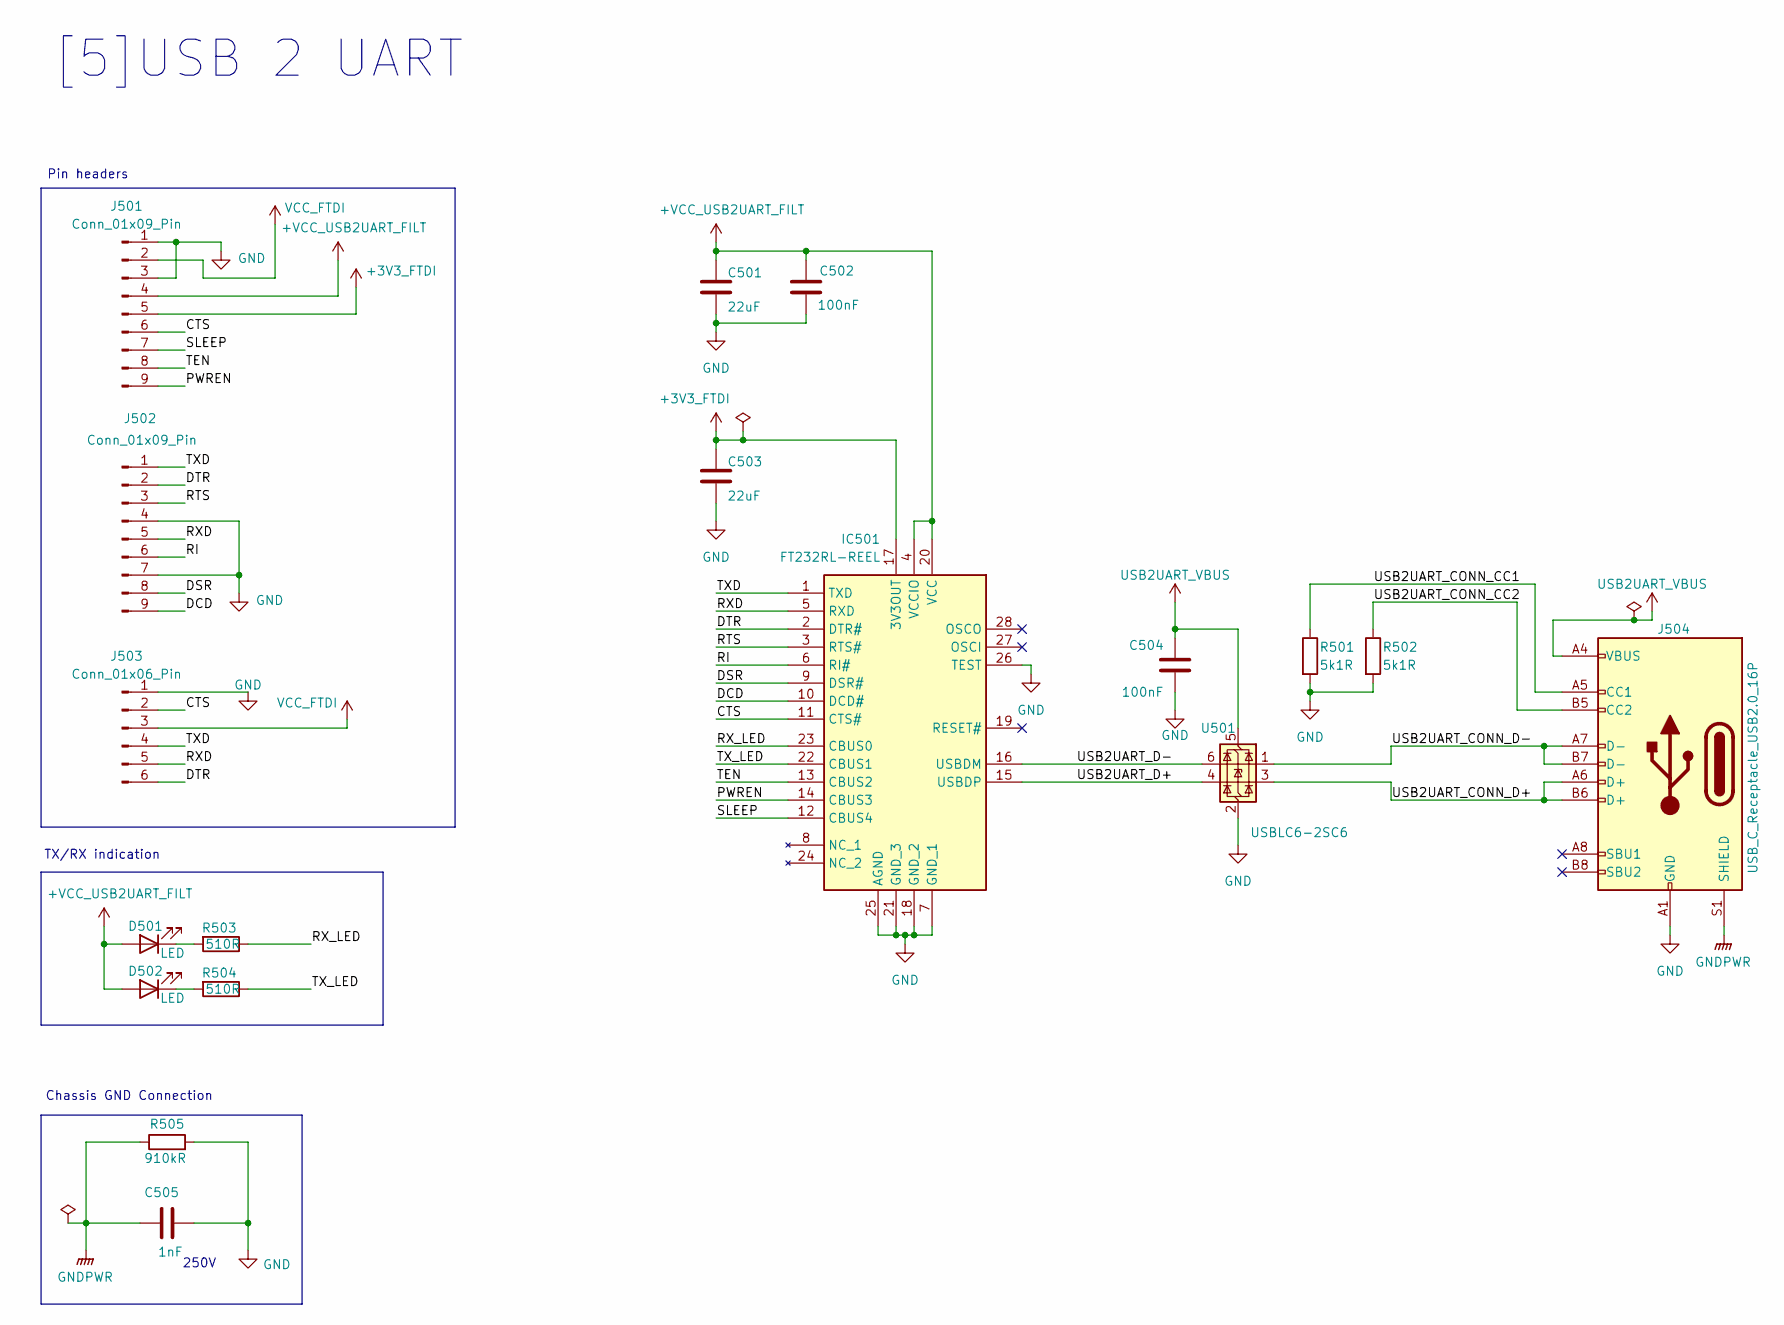
[picture p21: schematic 05_usb2uart.kicad_sch]

Parts:
C501, C503: 22uF; C_0603_1608Metric; Manufacturer Part Number CL10A226MP8NUNE; DigiKey Part Number 1276-6687-6-ND
C502, C504: 100nF; C_0402_1005Metric; Manufacturer Part Number CL05B104KO5NNNC; DigiKey Part Number 1276-1002-6-ND
C505: 1nF; C_0603_1608Metric; Manufacturer Part Number CC0603KRX7RYBB102
D501, D502: LED; LED_0603_1608Metric; Manufacturer Part Number XL-1608SURC-06
IC501: FT232RL-REEL; SOP65P778X200-28N; Manufacturer Part Number FT232RL-REEL
J501, J502: Conn_01x09_Pin; PinHeader_1x09_P2.54mm_Vertical
J503: Conn_01x06_Pin; PinHeader_1x06_P2.54mm_Vertical
J504: USB_C_Receptacle_USB2.0_16P; USB_C_Receptacle_HRO_TYPE-C-31-M-12; Manufacturer Part Number TYPE-C-31-M-12
R501, R502: 5k1R; R_0402_1005Metric; Manufacturer Part Number 0402WGF5101TCE
R503, R504: 510R; R_0402_1005Metric; Manufacturer Part Number 0402WGF5100TCE
R505: 910kR; R_0402_1005Metric; Manufacturer Part Number 0402WGJ0914TCE
U501: USBLC6-2SC6; SOT-23-6; Manufacturer Part Number USBLC6-2SC6; DigiKey Part Number 497-5235-6-ND

Connections:
+3V3_FTDI: C503.1, IC501.17 (3V3OUT), J501.5; also elsewhere on the board
+VCC_USB2UART_FILT: C501.1, C502.1, D501.2 (A), D502.2 (A), IC501.4 (VCCIO), IC501.20 (VCC), J501.4; also elsewhere on the board
/[5]USB 2 UART/CTS: IC501.11 (CTS#), J501.6, J503.2
/[5]USB 2 UART/DCD: IC501.10 (DCD#), J502.9
/[5]USB 2 UART/DSR: IC501.9 (DSR#), J502.8
/[5]USB 2 UART/DTR: IC501.2 (DTR#), J502.2, J503.6
/[5]USB 2 UART/PWREN: IC501.14 (CBUS3), J501.9
/[5]USB 2 UART/RI: IC501.6 (RI#), J502.6
/[5]USB 2 UART/RTS: IC501.3 (RTS#), J502.3
/[5]USB 2 UART/RXD: IC501.5 (RXD), J502.5, J503.5
/[5]USB 2 UART/RX_LED: IC501.23 (CBUS0), R503.1
/[5]USB 2 UART/SLEEP: IC501.12 (CBUS4), J501.7
/[5]USB 2 UART/TEN: IC501.13 (CBUS2), J501.8
/[5]USB 2 UART/TXD: IC501.1 (TXD), J502.1, J503.4
/[5]USB 2 UART/TX_LED: IC501.22 (CBUS1), R504.1
/[5]USB 2 UART/USB2UART_CONN_CC1: J504.A5 (CC1), R501.1
/[5]USB 2 UART/USB2UART_CONN_CC2: J504.B5 (CC2), R502.1
/[5]USB 2 UART/USB2UART_CONN_D+: J504.A6 (D+), J504.B6 (D+), U501.3 (I/O2)
/[5]USB 2 UART/USB2UART_CONN_D-: J504.A7 (D-), J504.B7 (D-), U501.1 (I/O1)
/[5]USB 2 UART/USB2UART_D+: IC501.15 (USBDP), U501.4 (I/O2)
/[5]USB 2 UART/USB2UART_D-: IC501.16 (USBDM), U501.6 (I/O1)
GND: C501.2, C502.2, C503.2, C504.2, C505.2, IC501.7 (GND_1), IC501.18 (GND_2), IC501.21 (GND_3), IC501.25 (AGND), IC501.26 (TEST), J501.1, J501.3, J502.4, J502.7, J503.1, J504.A1 (GND), J504.A12 (GND), J504.B1 (GND), J504.B12 (GND), R501.2, R502.2, R505.2, U501.2 (GND); also elsewhere on the board
GNDPWR: C505.1, J504.S1 (SHIELD), R505.1
unnamed: D501.1 (K), R503.2
unnamed: D502.1 (K), R504.2
USB2UART_VBUS: C504.1, J504.A4 (VBUS), J504.A9 (VBUS), J504.B4 (VBUS), J504.B9 (VBUS), U501.5 (VBUS); also elsewhere on the board
VCC_FTDI: J501.2, J503.3; also elsewhere on the board

Notes on the sheet:
Chassis GND Connection
[5]USB 2 UART
Pin headers
250V
TX/RX indication
