denisgav/solderless_breadboard_psu/KiCad/v1/solderless_breadboard_psu.kicad_pcb

## KiCad design KiCad/v1/solderless_breadboard_psu.kicad_pcb (continued)

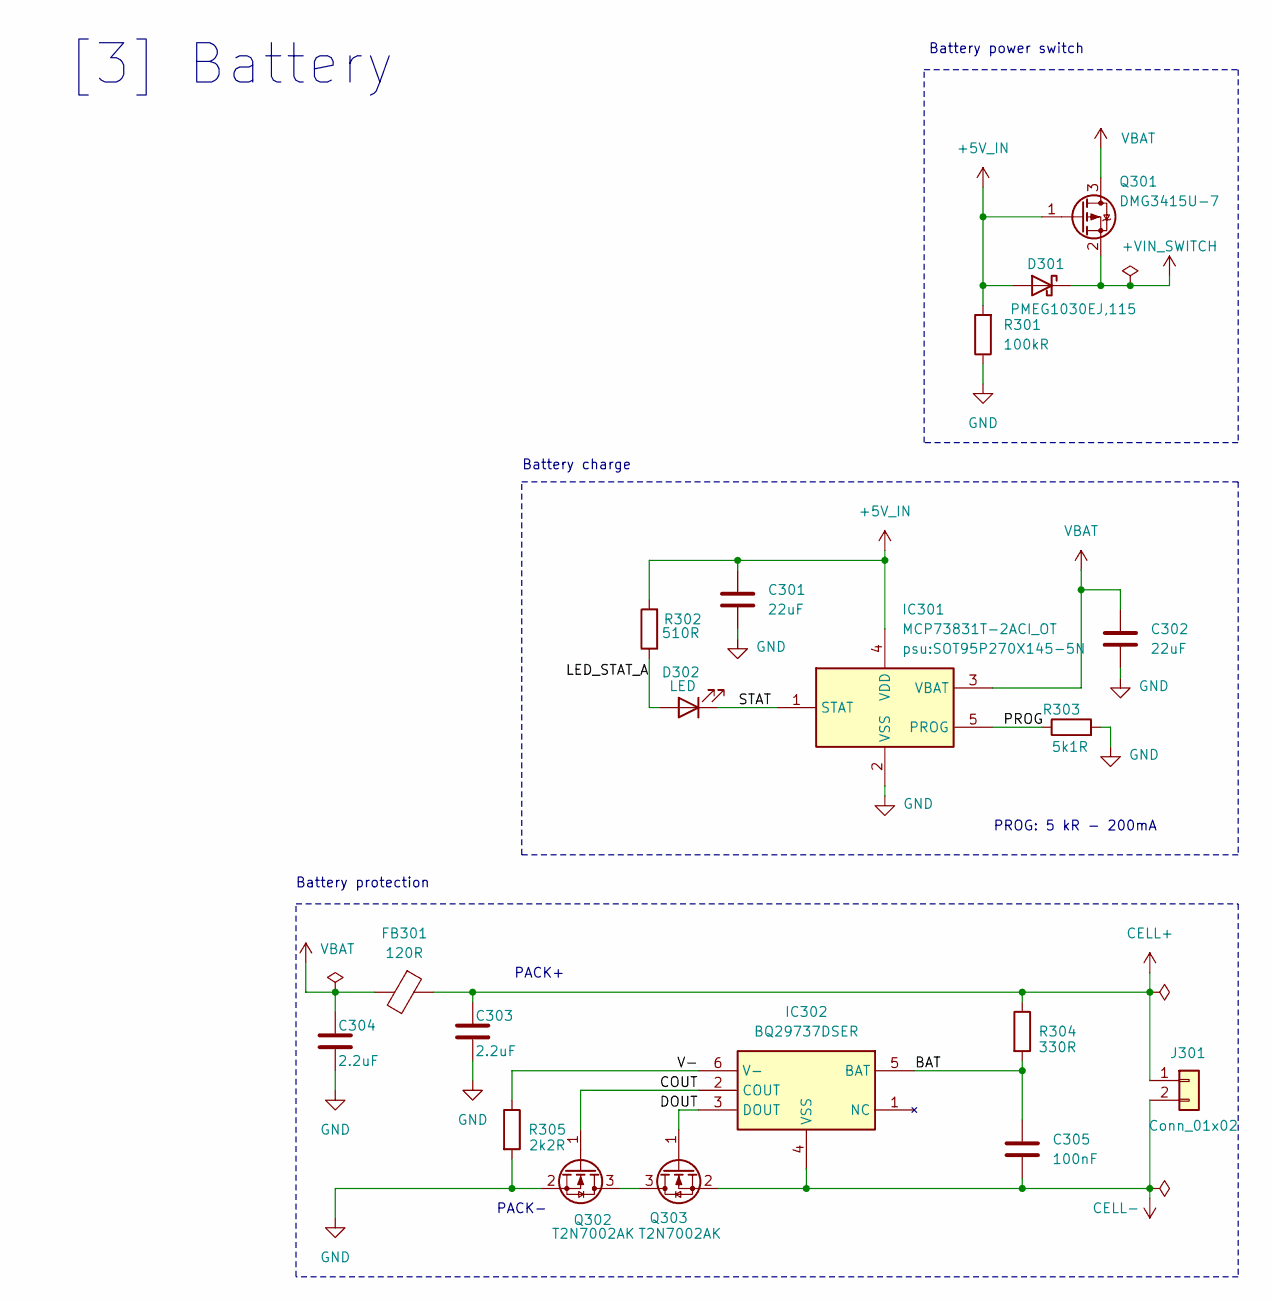
[picture p22: schematic 03_battery.kicad_sch]

Parts:
C301, C302: 22uF; C_0603_1608Metric; Manufacturer Part Number CL10A226MP8NUNE
C303, C304: 2.2uF; C_0603_1608Metric; Manufacturer Part Number CL10A225KO8NNNC
C305: 100nF; C_0402_1005Metric; Manufacturer Part Number CL05B104KO5NNNC
D301: PMEG1030EJ,115; D_SOD-323F; Manufacturer Part Number PMEG1030EJ,115
D302: LED; LED_0603_1608Metric; Manufacturer Part Number XL-1608SURC-06
FB301: 120R; Fuse_0603_1608Metric; Manufacturer Part Number BLM18PG121SN1D
IC301: MCP73831T-2ACI_OT; SOT95P270X145-5N; Manufacturer Part Number MCP73831T-2ACI/OT
IC302: BQ29737DSER; SON50P150X150X80-6N; Manufacturer Part Number BQ29737DSER
J301: Conn_01x02; PinHeader_1x02_P2.54mm_Vertical
Q301: DMG3415U-7; SOT-23; Manufacturer Part Number DMG3415U-7
Q302, Q303: T2N7002AK; SOT-23; Manufacturer Part Number T2N7002AK,LM
R301: 100kR; R_0402_1005Metric; Manufacturer Part Number 0402WGF1003TCE
R302: 510R; R_0402_1005Metric; Manufacturer Part Number 0402WGF5100TCE
R303: 5k1R; R_0402_1005Metric; Manufacturer Part Number 0402WGF5101TCE
R304: 330R; R_0402_1005Metric; Manufacturer Part Number 0402WGF3300TCE
R305: 2k2R; R_0402_1005Metric; Manufacturer Part Number 0402WGF2201TCE

Connections:
+5V_IN: C301.1, D301.2 (A), IC301.4 (VDD), Q301.1 (G), R301.2, R302.2; also elsewhere on the board
+VIN_SWITCH: D301.1 (K), Q301.2 (S); also elsewhere on the board
/[3] Battery/BAT: C305.1, IC302.5 (BAT), R304.2
/[3] Battery/COUT: IC302.2 (COUT), Q302.1 (G)
/[3] Battery/DOUT: IC302.3 (DOUT), Q303.1 (G)
/[3] Battery/LED_STAT_A: D302.2 (A), R302.1
/[3] Battery/PROG: IC301.5 (PROG), R303.1
/[3] Battery/STAT: D302.1 (K), IC301.1 (STAT)
/[3] Battery/V-: IC302.6 (V-), R305.1
CELL+: C303.1, FB301.1, J301.1, R304.1
CELL-: C305.2, IC302.4 (VSS), J301.2, Q303.2 (S)
GND: C301.2, C302.2, C303.2, C304.2, IC301.2 (VSS), Q302.2 (S), R301.1, R303.2, R305.2; also elsewhere on the board
unnamed: Q302.3 (D), Q303.3 (D)
VBAT: C302.1, C304.1, FB301.2, IC301.3 (VBAT), Q301.3 (D)

Notes on the sheet:
Battery charge
PACK-
Battery protection
Battery power switch
[3] Battery
PROG: 5 kR - 200mA
PACK+

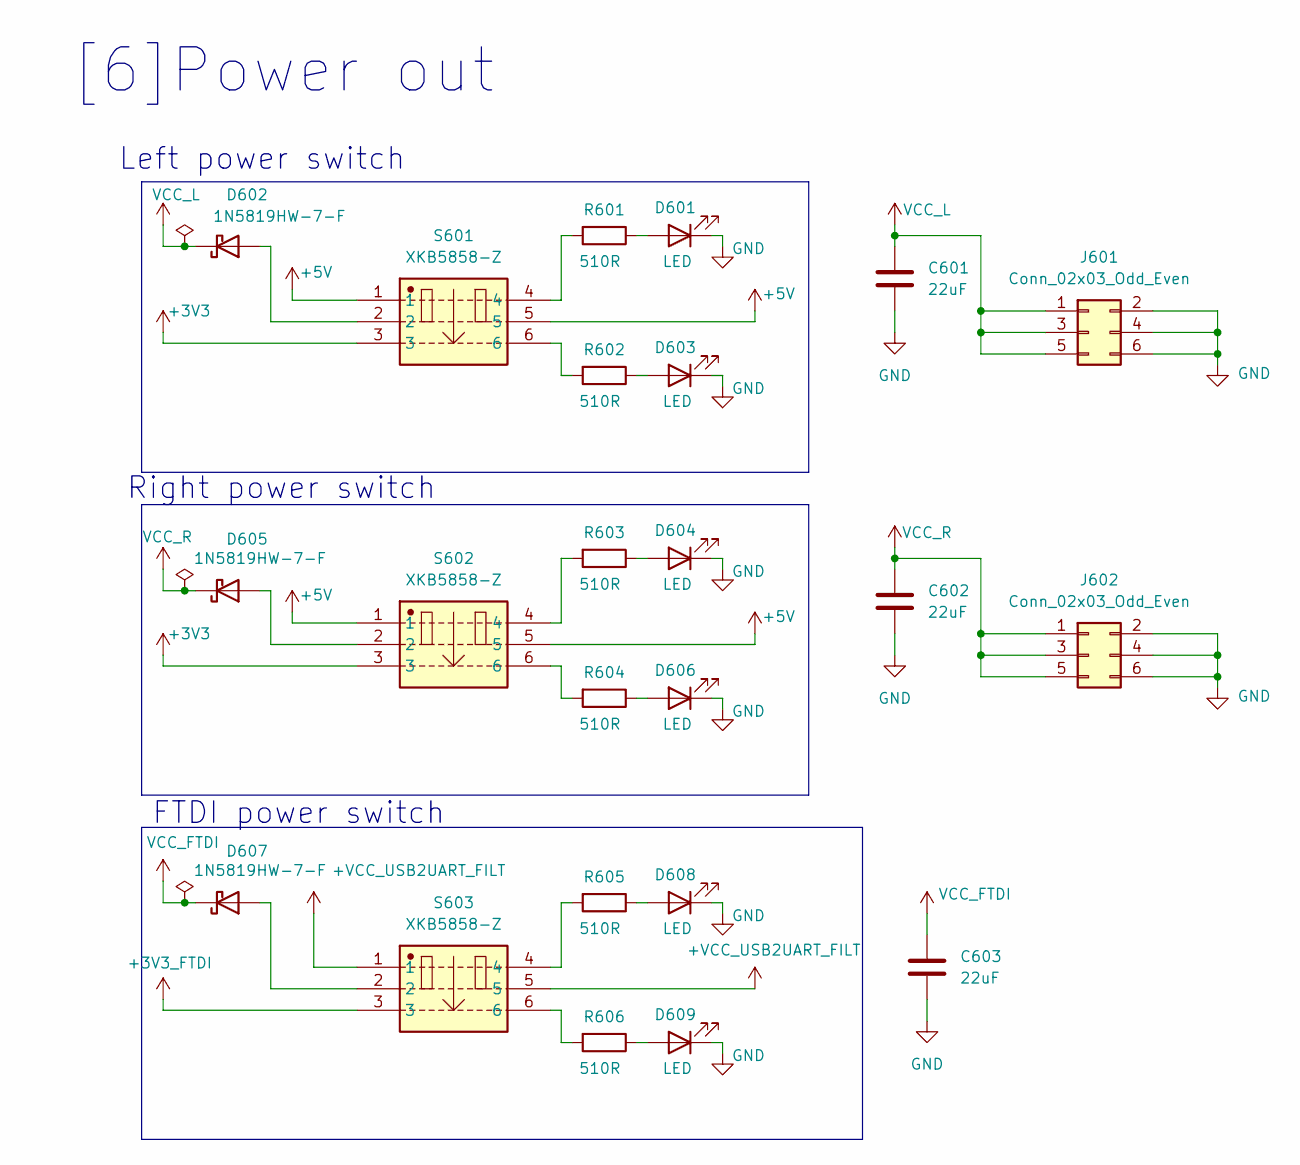
[picture p23: schematic 06_power_out.kicad_sch]

Parts:
C601, C602, C603: 22uF; C_0603_1608Metric; Manufacturer Part Number CL10A226MP8NUNE; DigiKey Part Number 1276-6687-6-ND
D601, D603, D604, D606, D608, D609: LED; LED_0603_1608Metric; Manufacturer Part Number XL-1608SURC-06
D602, D605, D607: 1N5819HW-7-F; D_SOD-123; Manufacturer Part Number 1N5819HW-7-F
J601, J602: Conn_02x03_Odd_Even; PinHeader_2x03_P2.54mm_Vertical
R601, R602, R603, R604, R605, R606: 510R; R_0402_1005Metric; Manufacturer Part Number 0402WGF5100TCE
S601, S602, S603: XKB5858-Z; XKB5858Z; Manufacturer Part Number XKB5858-Z

Connections:
+3V3: S601.3, S602.3; also elsewhere on the board
+3V3_FTDI: S603.3; also elsewhere on the board
+5V: S601.1, S601.5, S602.1, S602.5; also elsewhere on the board
+VCC_USB2UART_FILT: S603.1, S603.5; also elsewhere on the board
GND: C601.2, C602.2, C603.2, D601.1 (K), D603.1 (K), D604.1 (K), D606.1 (K), D608.1 (K), D609.1 (K), J601.2, J601.4, J601.6, J602.2, J602.4, J602.6; also elsewhere on the board
unnamed: D601.2 (A), R601.1
unnamed: D602.2 (A), S601.2
unnamed: D603.2 (A), R602.1
unnamed: D604.2 (A), R603.1
unnamed: D605.2 (A), S602.2
unnamed: D606.2 (A), R604.1
unnamed: D607.2 (A), S603.2
unnamed: D608.2 (A), R605.1
unnamed: D609.2 (A), R606.1
unnamed: R601.2, S601.4
unnamed: R602.2, S601.6
unnamed: R603.2, S602.4
unnamed: R604.2, S602.6
unnamed: R605.2, S603.4
unnamed: R606.2, S603.6
VCC_FTDI: C603.1, D607.1 (K); also elsewhere on the board
VCC_L: C601.1, D602.1 (K), J601.1, J601.3, J601.5
VCC_R: C602.1, D605.1 (K), J602.1, J602.3, J602.5

Notes on the sheet:
FTDI power switch
Left power switch
Right power switch
[6]Power out

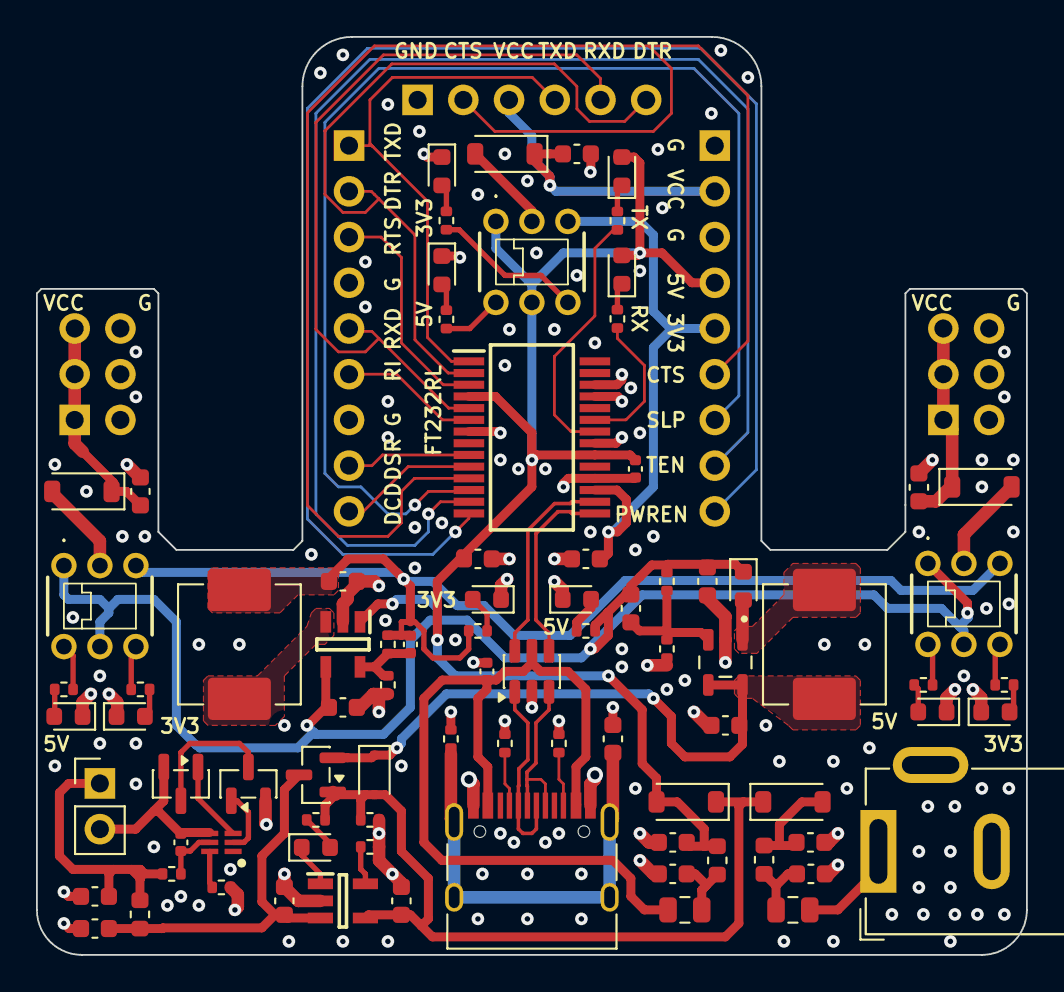
[picture p24: board KiCad/v1/solderless_breadboard_psu.kicad_pcb from above]

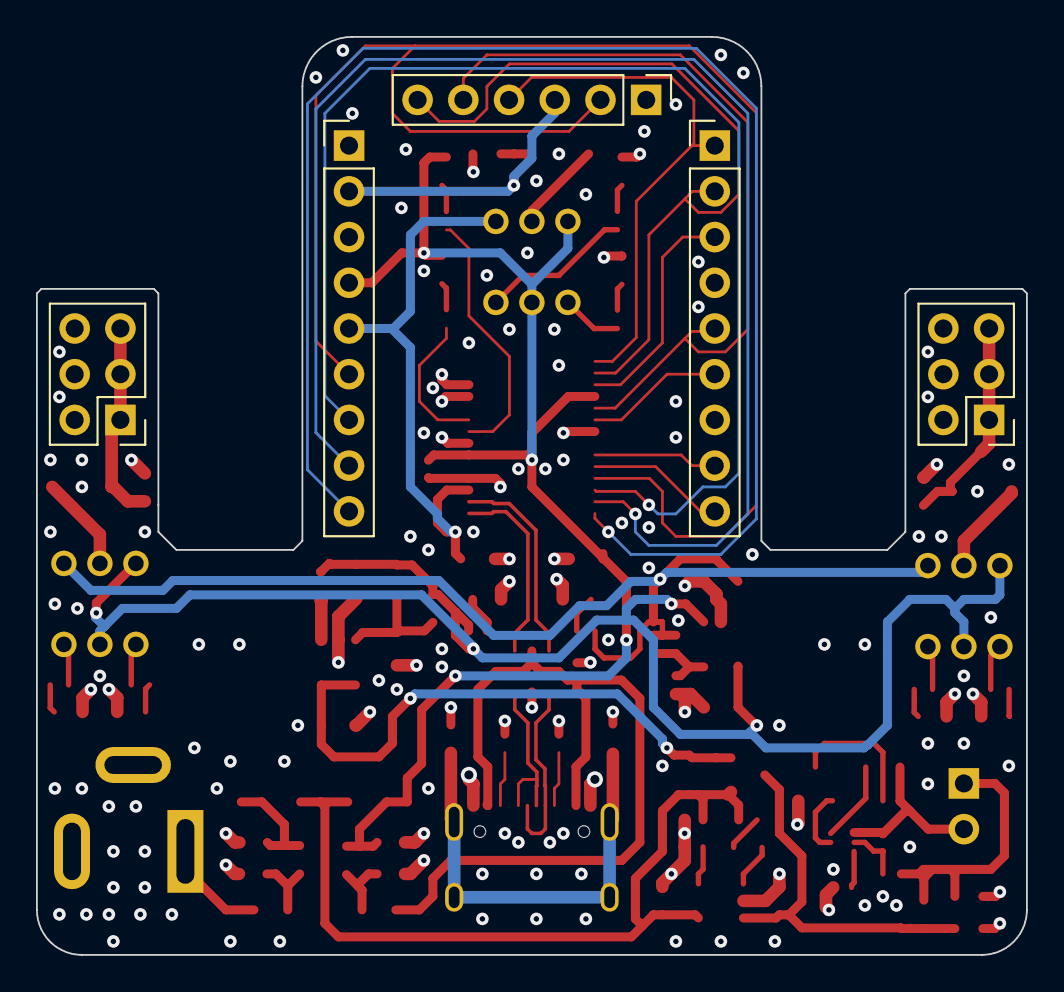
[picture p25: board KiCad/v1/solderless_breadboard_psu.kicad_pcb from below]

Board: 4 copper layers, 55.0 x 51.0 mm, 90 parts (5 on the bottom side), 69 nets.
