denisgav/solderless_breadboard_psu/(commit log)

2026-01-10 First scheme complete
    [02_power_input.kicad_sch, 03_battery.kicad_sch, 04_buck_boost.kicad_sch, 05_usb2uart.kicad_sch, 06_power_out.kicad_sch, SW_Btn_XLX.step, XKB5858-Z.stp, solderless_breadboard_psu.kicad_pcb]
2026-01-10 Add power out capacitors
    [05_usb2uart.kicad_sch, 06_power_out.kicad_sch]
2026-01-11 ERC fixes
    [03_battery.kicad_sch, 05_usb2uart.kicad_sch, 06_power_out.kicad_sch, solderless_breadboard_psu.kicad_pcb]
2026-01-11 basic PCB
    [05_usb2uart.kicad_sch, solderless_breadboard_psu.kicad_pcb]
2026-01-11 minor pcb update
    [03_battery.kicad_sch, solderless_breadboard_psu.kicad_pcb]
2026-01-11 Calculated pin headers positions
    [05_usb2uart.kicad_sch, solderless_breadboard_psu.kicad_pcb]
2026-01-13 minor PCB updates
    [solderless_breadboard_psu.kicad_pcb]
2026-01-15 Add board edge cuts
    [solderless_breadboard_psu.kicad_pcb]
2026-01-17 Update FTDI pin header
    [03_battery.kicad_sch, 05_usb2uart.kicad_sch, solderless_breadboard_psu.kicad_pcb]
2026-01-17 USB routing
    [solderless_breadboard_psu.kicad_pcb]
2026-01-17 PCB UART routing
    [05_usb2uart.kicad_sch, solderless_breadboard_psu.kicad_pcb]
2026-01-17 Update FTDI pinout
    [05_usb2uart.kicad_sch, solderless_breadboard_psu.kicad_pcb]
2026-01-18 FTDI signals routing
    [05_usb2uart.kicad_sch, solderless_breadboard_psu.kicad_pcb]
2026-01-18 battery connector PCB routing
    [06_power_out.kicad_sch, HRO TYPE-C-31-M-12.step, solderless_breadboard_psu.kicad_pcb]
2026-01-18 PCB route complete
    [solderless_breadboard_psu.kicad_pcb]
2026-01-18 PCB DRC fixes
    [solderless_breadboard_psu.kicad_pcb]
2026-01-24 Fill BOM table
    [02_power_input.kicad_sch, 03_battery.kicad_sch, 04_buck_boost.kicad_sch, 05_usb2uart.kicad_sch, 06_power_out.kicad_sch, solderless_breadboard_psu.kicad_pcb]
2026-01-24 Production files
    [04_buck_boost.kicad_sch, 05_usb2uart.kicad_sch, bom.csv, designators.csv, positions.csv, solderless_breadboard_psu.csv, solderless_breadboard_psu.kicad_pcb]
2026-01-24 battery connector update
    [03_battery.kicad_sch, 04_buck_boost.kicad_sch, solderless_breadboard_psu.kicad_pcb]
2026-01-25 Update battery connector
    [05_usb2uart.kicad_sch, 06_power_out.kicad_sch, bom.csv, designators.csv, positions.csv, solderless_breadboard_psu.csv, solderless_breadboard_psu.kicad_pcb]
2026-01-25 Update pin header offset. Clean DRC error
    [positions.csv, solderless_breadboard_psu.kicad_pcb]
2026-01-25 JLCPCB check fixes
    [solderless_breadboard_psu.kicad_pcb]
2026-02-28 BOM updates
    [03_battery.kicad_sch, 04_buck_boost.kicad_sch, 05_usb2uart.kicad_sch, 06_power_out.kicad_sch, not_ordered.ods, solderless_breadboard_psu.csv]
2026-03-15 Update resistor values
    [solderless_breadboard_psu.kicad_pcb]
2026-05-03 Add V2 folder
    [02_power.kicad_sch, 02_power_input.kicad_sch, 03_battery.kicad_sch, 03_usb2uart.kicad_sch, 04_buck_boost.kicad_sch, 05_usb2uart.kicad_sch, 06_power_out.kicad_sch, BM02B-GHS-TBT_LF__SN__N_.stp]
2026-05-03 USB2UART scheme update
    [03_usb2uart.kicad_sch, CP2102N-A02-GQFN24R.stp]
2026-05-04 scheme for voltage regulators
    [02_power.kicad_sch, 03_usb2uart.kicad_sch]
2026-05-05 Update USB connection scheme
    [02_power.kicad_sch, 03_usb2uart.kicad_sch, solderless_breadboard_psu.kicad_pcb]
2026-05-06 Scheme updates
    [02_power.kicad_sch, 03_usb2uart.kicad_sch, HRO TYPE-C-31-M-12.step, SW_PUSH_6mm_H5mm.step, solderless_breadboard_psu.kicad_pcb]
2026-05-06 update FB capacitors
    [02_power.kicad_sch, solderless_breadboard_psu.kicad_pcb]
2026-05-07 Initial components placement
    [02_power.kicad_sch, 03_usb2uart.kicad_sch, solderless_breadboard_psu.kicad_pcb]
2026-05-08 PCB layout updates
    [solderless_breadboard_psu.kicad_pcb]
2026-05-09 board outline fix
    [solderless_breadboard_psu.kicad_pcb]
2026-05-09 initial routing
    [03_usb2uart.kicad_sch, solderless_breadboard_psu.kicad_pcb]
2026-05-09 power signals routing
    [solderless_breadboard_psu.kicad_pcb]
2026-05-10 Signal routing
    [03_usb2uart.kicad_sch, solderless_breadboard_psu.kicad_pcb]
2026-05-10 First routing
    [solderless_breadboard_psu.kicad_pcb]
2026-05-11 silkscreen updates
    [solderless_breadboard_psu.kicad_pcb]
